usevolt/keypad/sw/doc/l_keypad.jpg

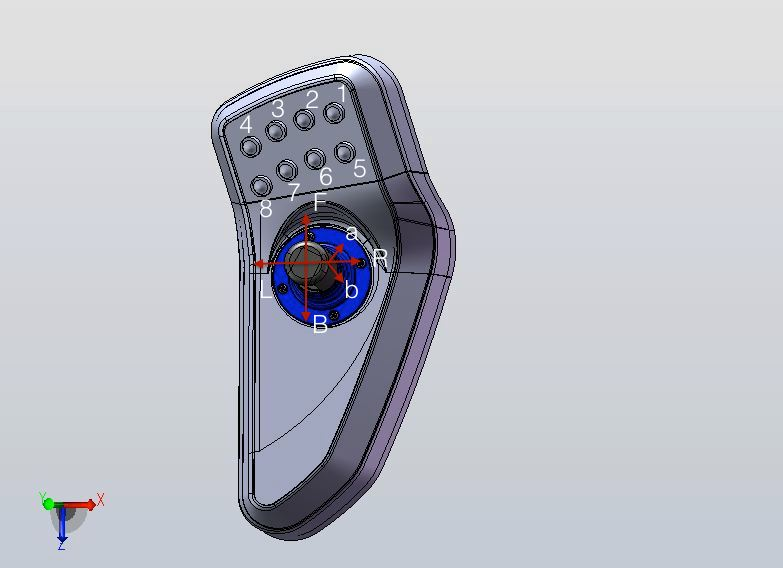
sw/doc/l_keypad.jpg
