usevolt/keypad/sw/doc/r_keypad.jpg

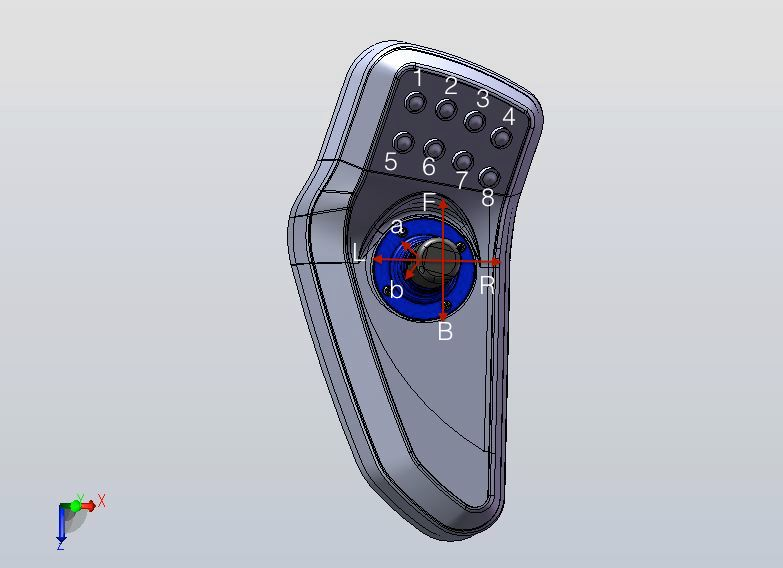
sw/doc/r_keypad.jpg
