usevolt/keypad/hw/angle2.png

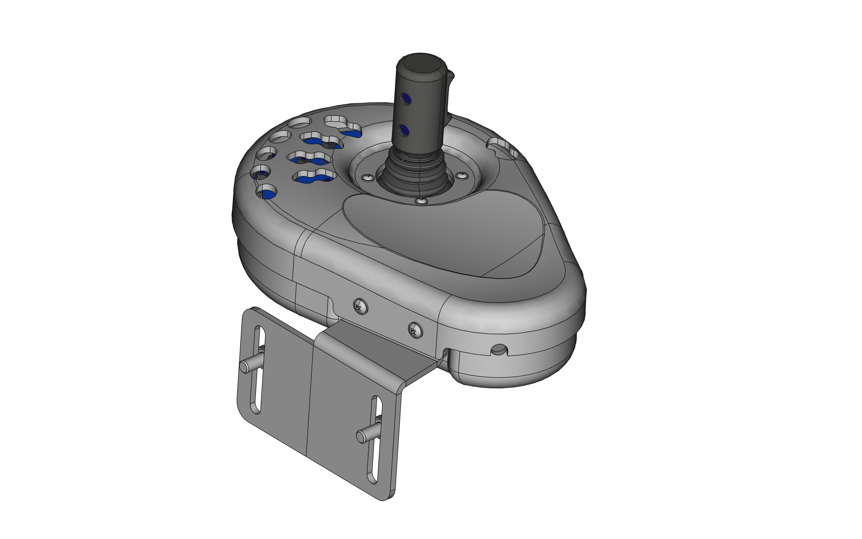
hw/angle2.png
