usevolt/keypad/hw/angle.png

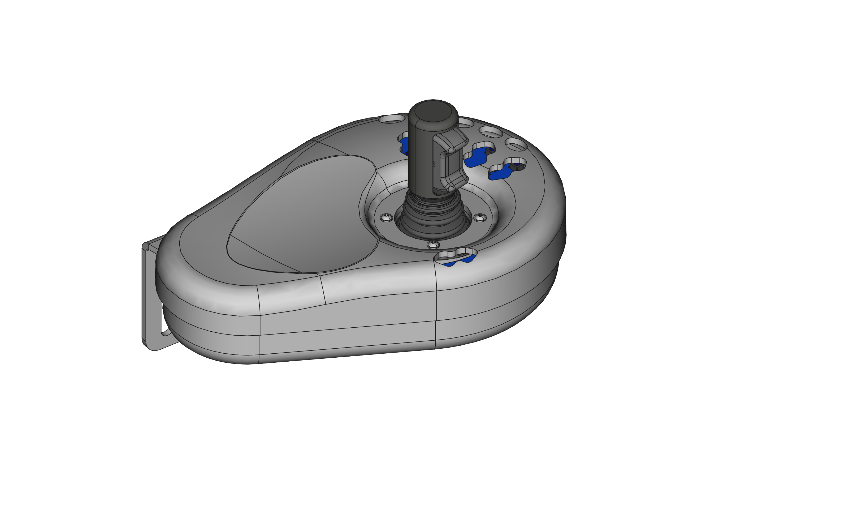
hw/angle.png
