usevolt/keypad/hw/front.png

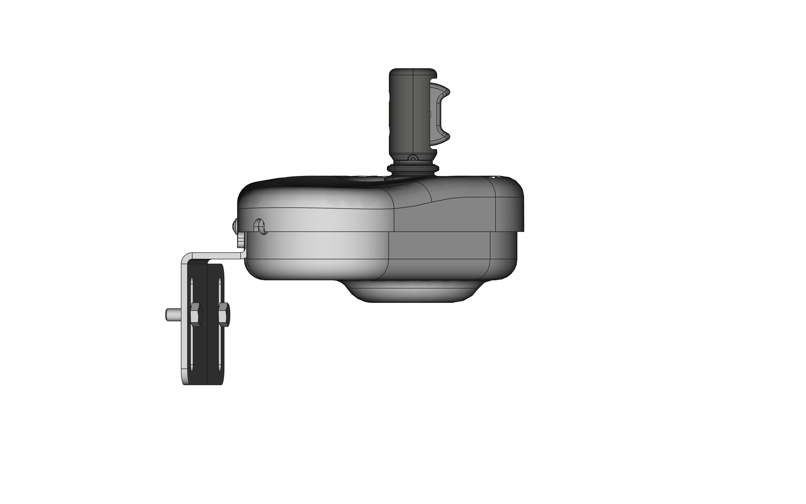
hw/front.png
