usevolt/keypad/hw/right_cover_without_buttons.step

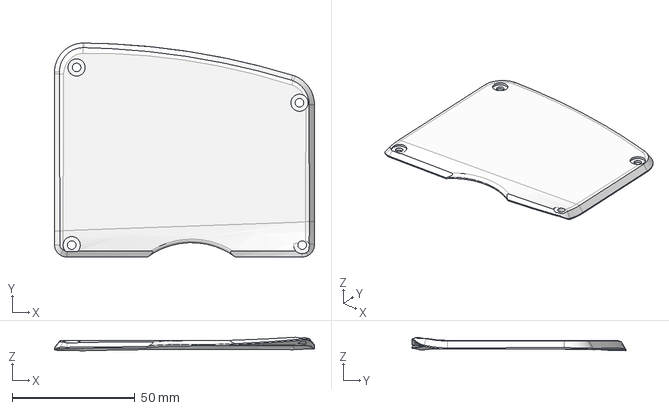
[picture p6: CAD file, 2021-10-26]
hw/right_cover_without_buttons.step
106.0 x 87.2 x 5.54 mm
