usevolt/keypad/hw/right_buttons.stl

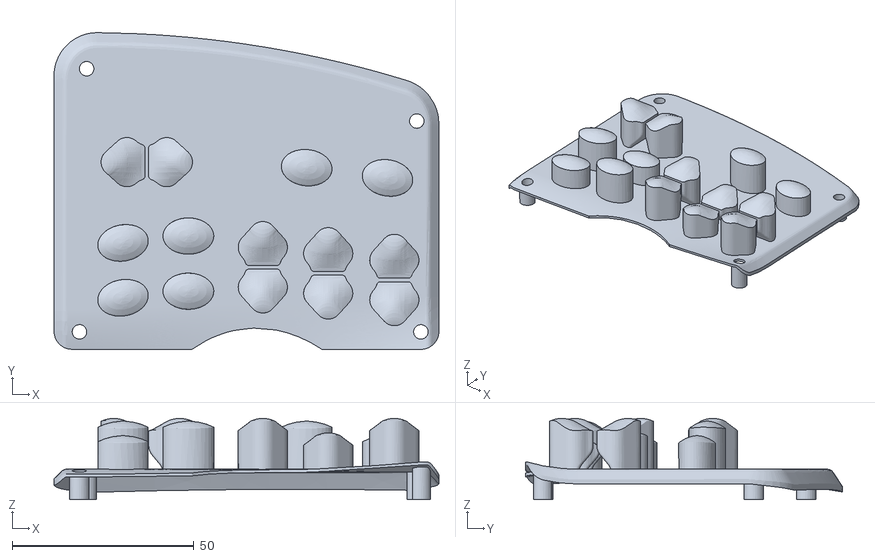
[picture p7: CAD file, 2019-06-02]
hw/right_buttons.stl
106.0 x 87.2 x 22.4
