usevolt/keypad/hw/collar_bottom.iges

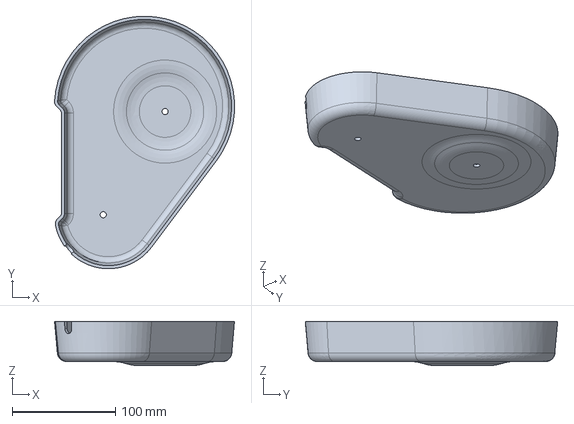
[picture p8: CAD file, 2018-08-27]
hw/collar_bottom.iges
174.5 x 244.8 x 43.0 mm
