usevolt/keypad/hw/collar_top.iges

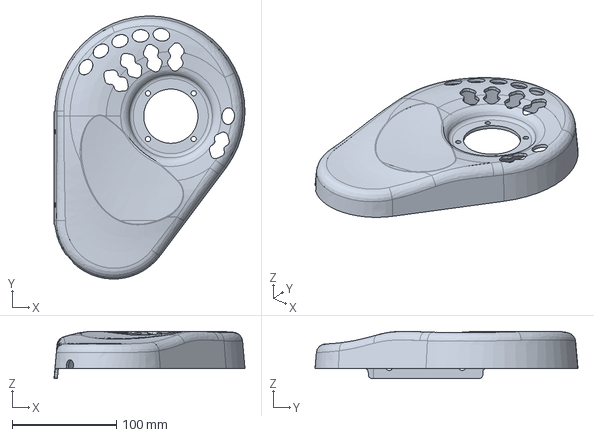
[picture p9: CAD file, 2018-08-27]
hw/collar_top.iges
183.0 x 252.1 x 45.5 mm
