usevolt/keypad/hw/pcb_edges_right.dxf

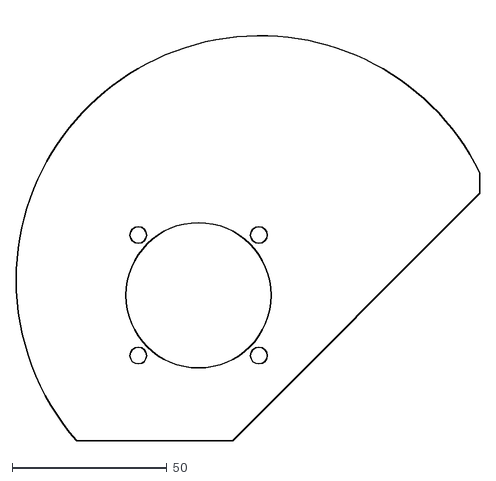
[picture p10: CAD file, 2017-12-17]
hw/pcb_edges_right.dxf
150.0 x 137.3
