usevolt/keypad/hw/joystick_edges_right.dxf

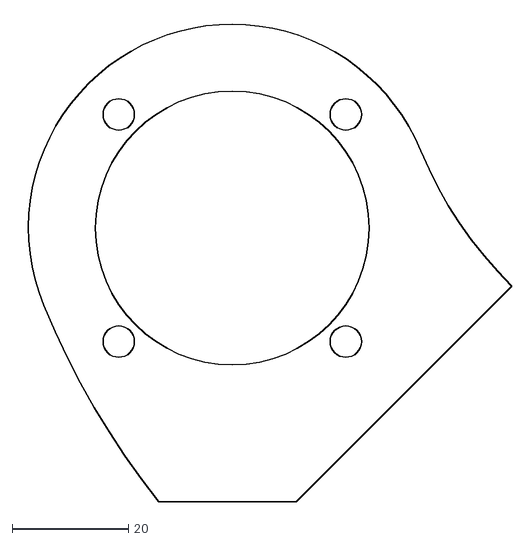
[picture p11: CAD file, 2017-12-17]
hw/joystick_edges_right.dxf
85.2 x 83.4
