usevolt/keypad/hw/left2.FCStd

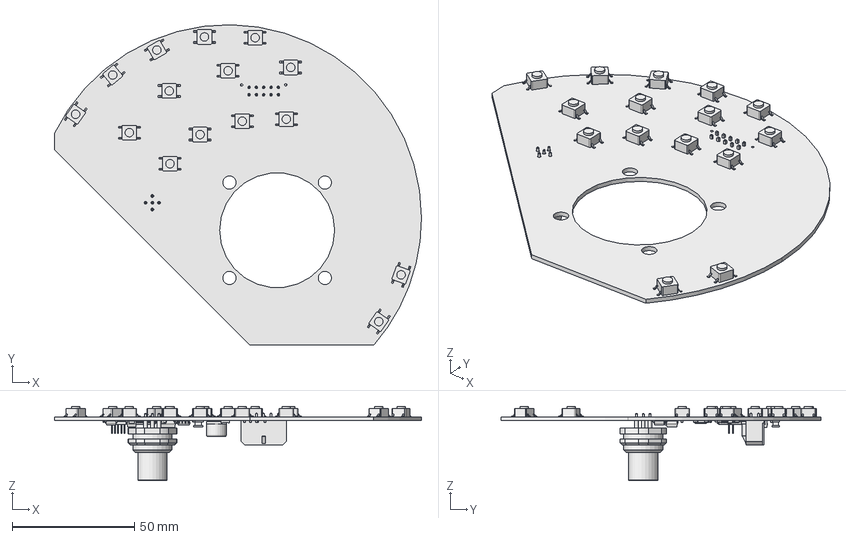
[picture p12: CAD file, 2017-12-17]
hw/left2.FCStd
150.0 x 131.0 x 30.4 mm
