usevolt/keypad/hw/joystick_edges.dxf

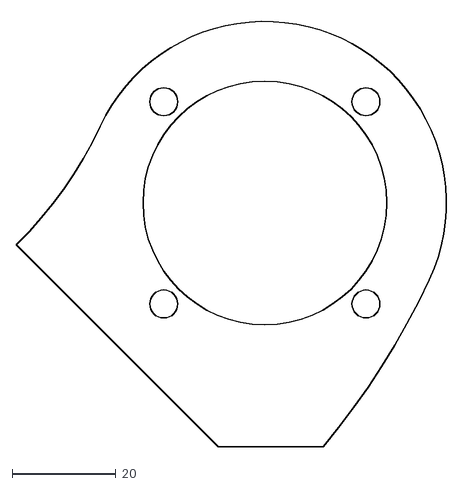
[picture p13: CAD file, 2017-12-17]
hw/joystick_edges.dxf
85.0 x 83.0
