usevolt/keypad/hw/button_edges_right.dxf

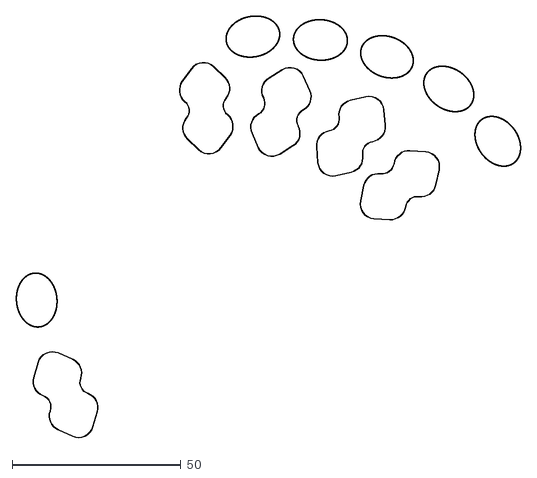
[picture p14: CAD file, 2017-12-17]
hw/button_edges_right.dxf
149.3 x 124.9
