usevolt/keypad/hw/pcb_edges.dxf

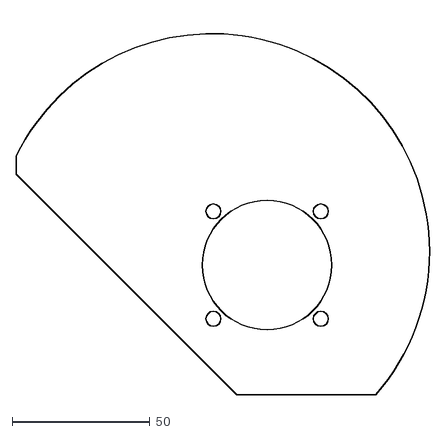
[picture p15: CAD file, 2017-12-17]
hw/pcb_edges.dxf
150.0 x 137.3
