usevolt/keypad/hw/mounting_metal_unfold.dxf

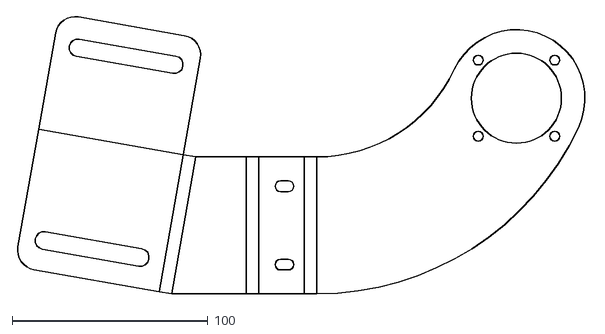
[picture p16: CAD file, 2017-12-17]
hw/mounting_metal_unfold.dxf
292.7 x 142.0
