usevolt/keypad/hw/button_edges.dxf

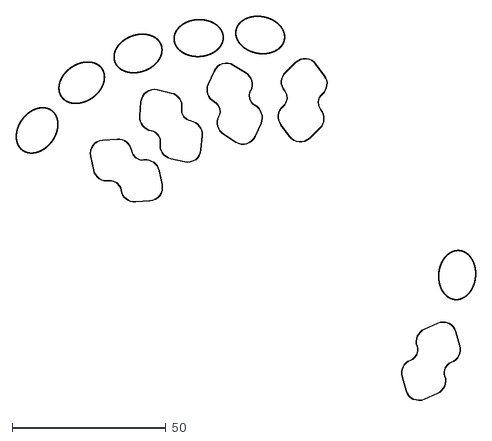
[picture p17: CAD file, 2017-12-17]
hw/button_edges.dxf
149.3 x 124.9
