usevolt/keypad/hw/button_base.step

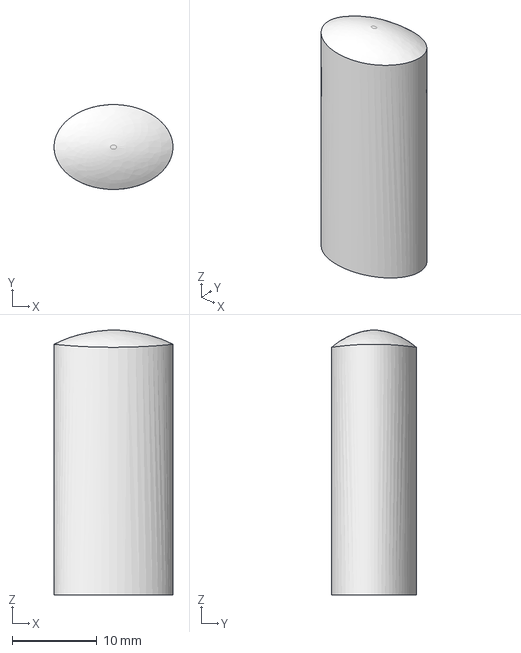
[picture p18: CAD file, 2017-07-12]
hw/button_base.step
14.0 x 9.99 x 31.2 mm
