usevolt/keypad/hw/button_hole_base.step

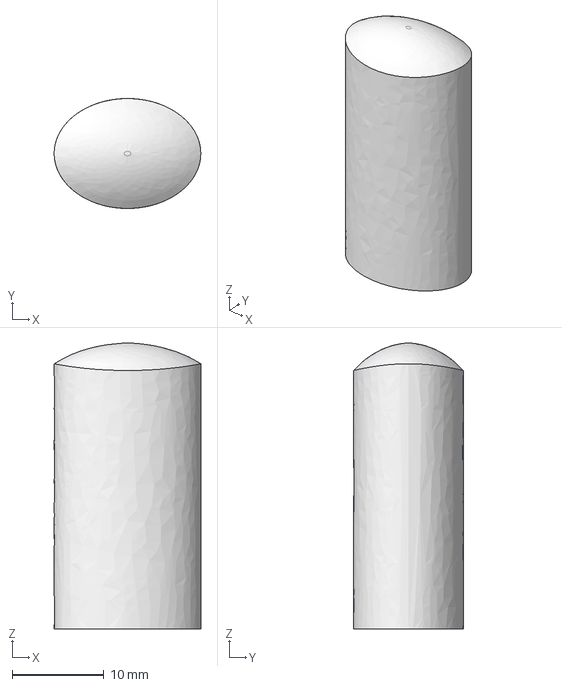
[picture p19: CAD file, 2017-07-12]
hw/button_hole_base.step
16.0 x 12.0 x 31.2 mm
