usevolt/keypad/hw/sw_base.step

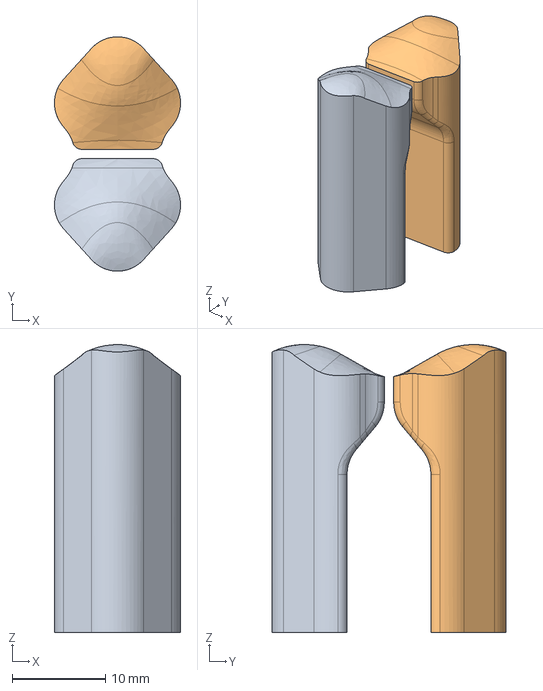
[picture p20: CAD file, 2017-07-12]
hw/sw_base.step
13.6 x 25.2 x 30.9 mm
