usevolt/keypad/hw/sw_hole_base.step

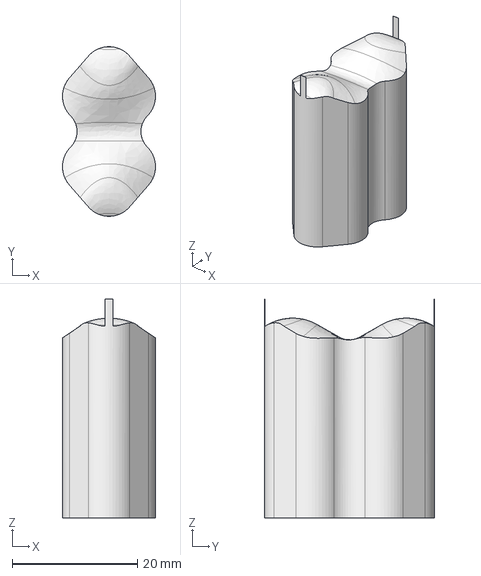
[picture p21: CAD file, 2017-07-12]
hw/sw_hole_base.step
14.9 x 27.1 x 35.0 mm
