usevolt/keypad/hw/right_cover.stl

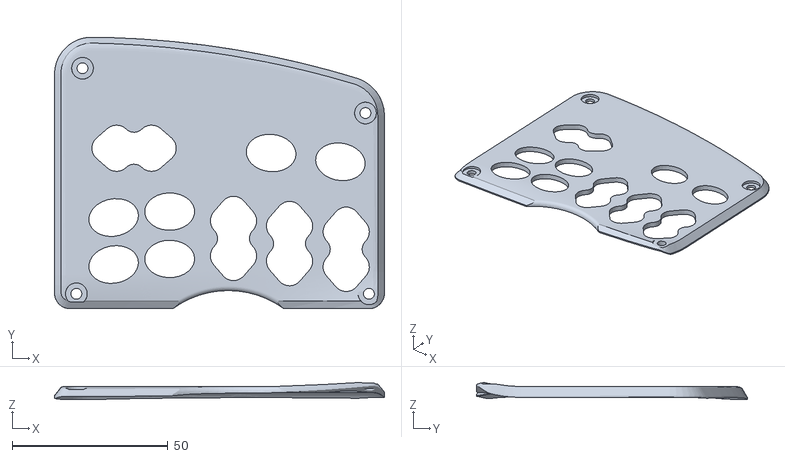
[picture p22: CAD file, 2017-05-18]
hw/right_cover.stl
106.0 x 87.2 x 5.54
