usevolt/keypad/hw/UWP-01004.step

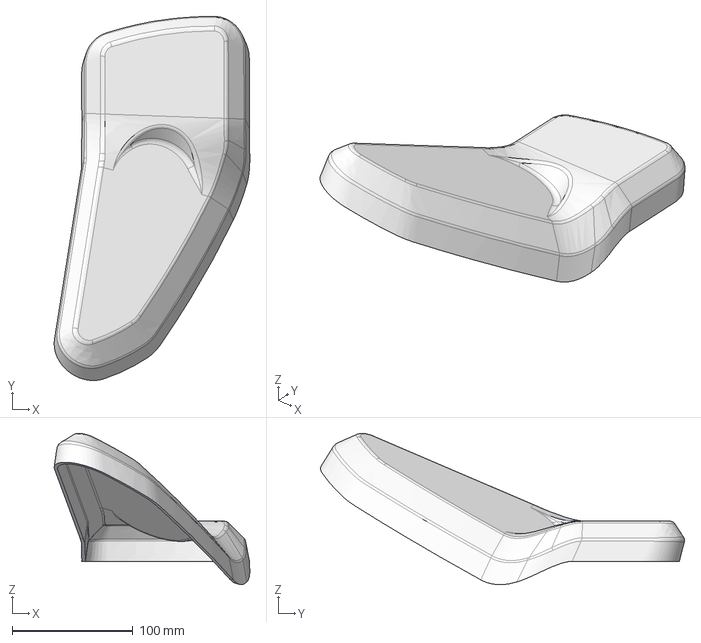
[picture p23: CAD file, 2017-03-28]
hw/UWP-01004.step
162.2 x 301.7 x 125.4 mm
