usevolt/keypad/hw/sw_short_base.step

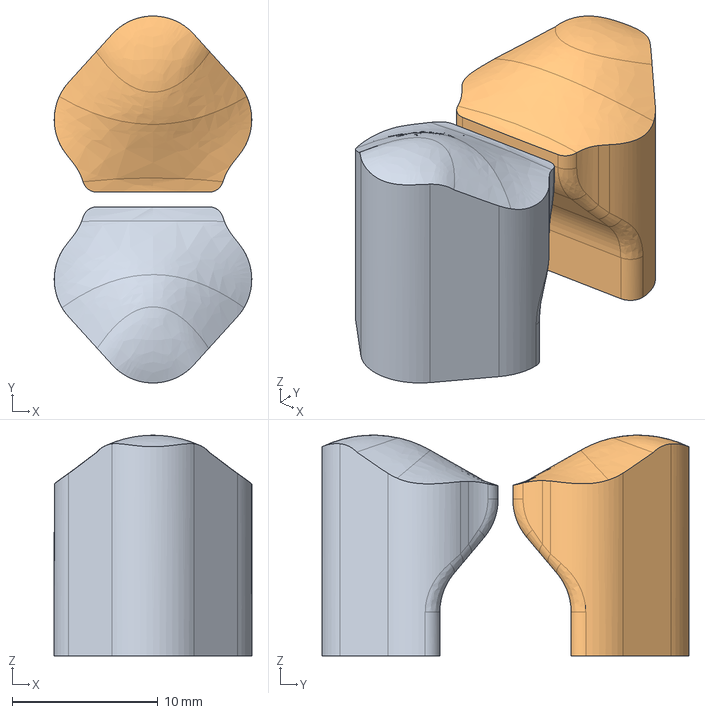
[picture p24: CAD file, 2017-03-28]
hw/sw_short_base.step
13.6 x 25.2 x 15.1 mm
