usevolt/keypad/(list of files, cad)

Other CAD files:
hw/left_cover_without_buttons.step
hw/left_buttons.stl
hw/button_bases.fcstd
hw/left_cover.stl
hw/collar_top.stl
hw/left_cover_without_buttons.stl
hw/right_cover_without_buttons.stl
