usevolt/keypad/docs/left_assembly.png

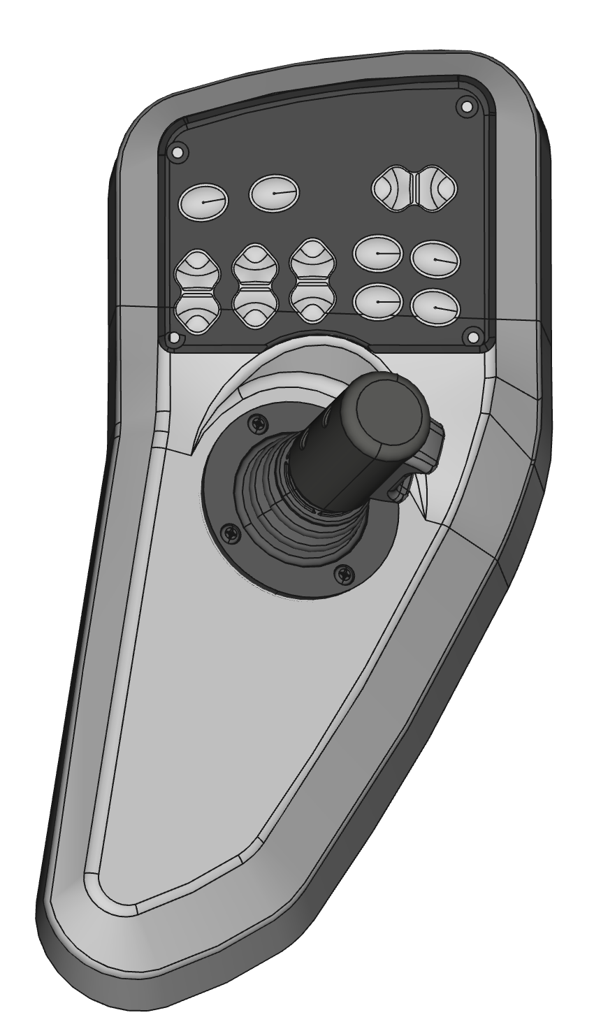
docs/left_assembly.png
