usevolt/keypad/hw/left2.kicad_pcb

## KiCad design hw/left2.kicad_pcb (2017-12-17)

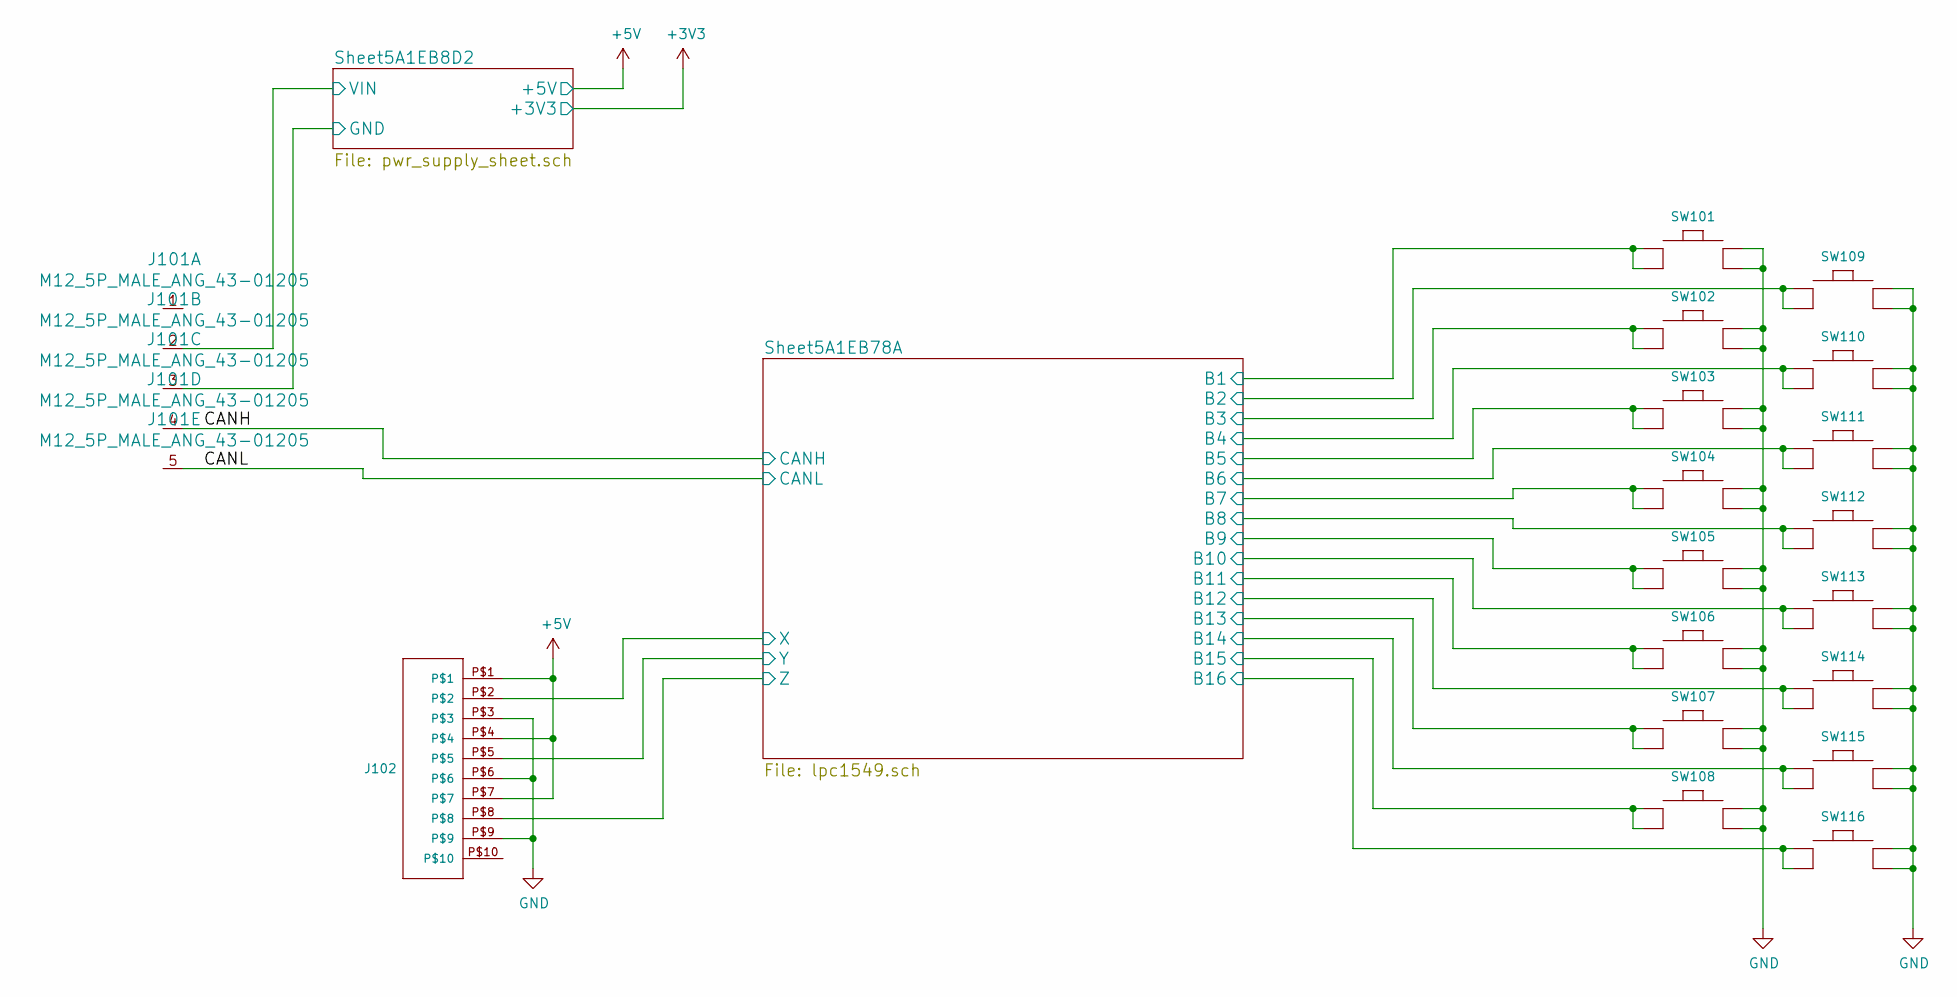
[picture p26: schematic left2.sch]

Parts:
J101: M12_5P_MALE_ANG_43-01205; Manufacturer Part Number 43-01205
J102: MOLEX_MICRO-FIT_10WAY_V; Manufacturer Part Number 43045-1027
SW101, SW102, SW103, SW104, SW105, SW106, SW107, SW108, SW109, SW110, SW111, SW112, SW113, SW114, SW115, SW116: SWITCH_PTS645SM43SMTR92; Manufacturer Part Number PTS645SM43SMTR92 LFS

Connections:
+5V: J102.P$1, J102.P$4, J102.P$7; also elsewhere on the board
/CANH: J101.4; also elsewhere on the board
/CANL: J101.5; also elsewhere on the board
/Sheet5A1EB8D2/VIN: J101.2; also elsewhere on the board
/Sheet5A1EB78A/B1: SW101.1, SW101.2; also elsewhere on the board
/Sheet5A1EB78A/B2: SW109.1, SW109.2; also elsewhere on the board
/Sheet5A1EB78A/B3: SW102.1, SW102.2; also elsewhere on the board
/Sheet5A1EB78A/B4: SW110.1, SW110.2; also elsewhere on the board
/Sheet5A1EB78A/B5: SW103.1, SW103.2; also elsewhere on the board
/Sheet5A1EB78A/B6: SW111.1, SW111.2; also elsewhere on the board
/Sheet5A1EB78A/B7: SW104.1, SW104.2; also elsewhere on the board
/Sheet5A1EB78A/B8: SW112.1, SW112.2; also elsewhere on the board
/Sheet5A1EB78A/B9: SW105.1, SW105.2; also elsewhere on the board
/Sheet5A1EB78A/B10: SW113.1, SW113.2; also elsewhere on the board
/Sheet5A1EB78A/B11: SW106.1, SW106.2; also elsewhere on the board
/Sheet5A1EB78A/B12: SW114.1, SW114.2; also elsewhere on the board
/Sheet5A1EB78A/B13: SW107.1, SW107.2; also elsewhere on the board
/Sheet5A1EB78A/B14: SW115.1, SW115.2; also elsewhere on the board
/Sheet5A1EB78A/B15: SW108.1, SW108.2; also elsewhere on the board
/Sheet5A1EB78A/B16: SW116.1, SW116.2; also elsewhere on the board
/Sheet5A1EB78A/X: J102.P$2; also elsewhere on the board
/Sheet5A1EB78A/Y: J102.P$5; also elsewhere on the board
/Sheet5A1EB78A/Z: J102.P$8; also elsewhere on the board
GND: J101.3, J102.P$3, J102.P$6, J102.P$9, SW101.3, SW101.4, SW102.3, SW102.4, SW103.3, SW103.4, SW104.3, SW104.4, SW105.3, SW105.4, SW106.3, SW106.4, SW107.3, SW107.4, SW108.3, SW108.4, SW109.3, SW109.4, SW110.3, SW110.4, SW111.3, SW111.4, SW112.3, SW112.4, SW113.3, SW113.4, SW114.3, SW114.4, SW115.3, SW115.4, SW116.3, SW116.4; also elsewhere on the board

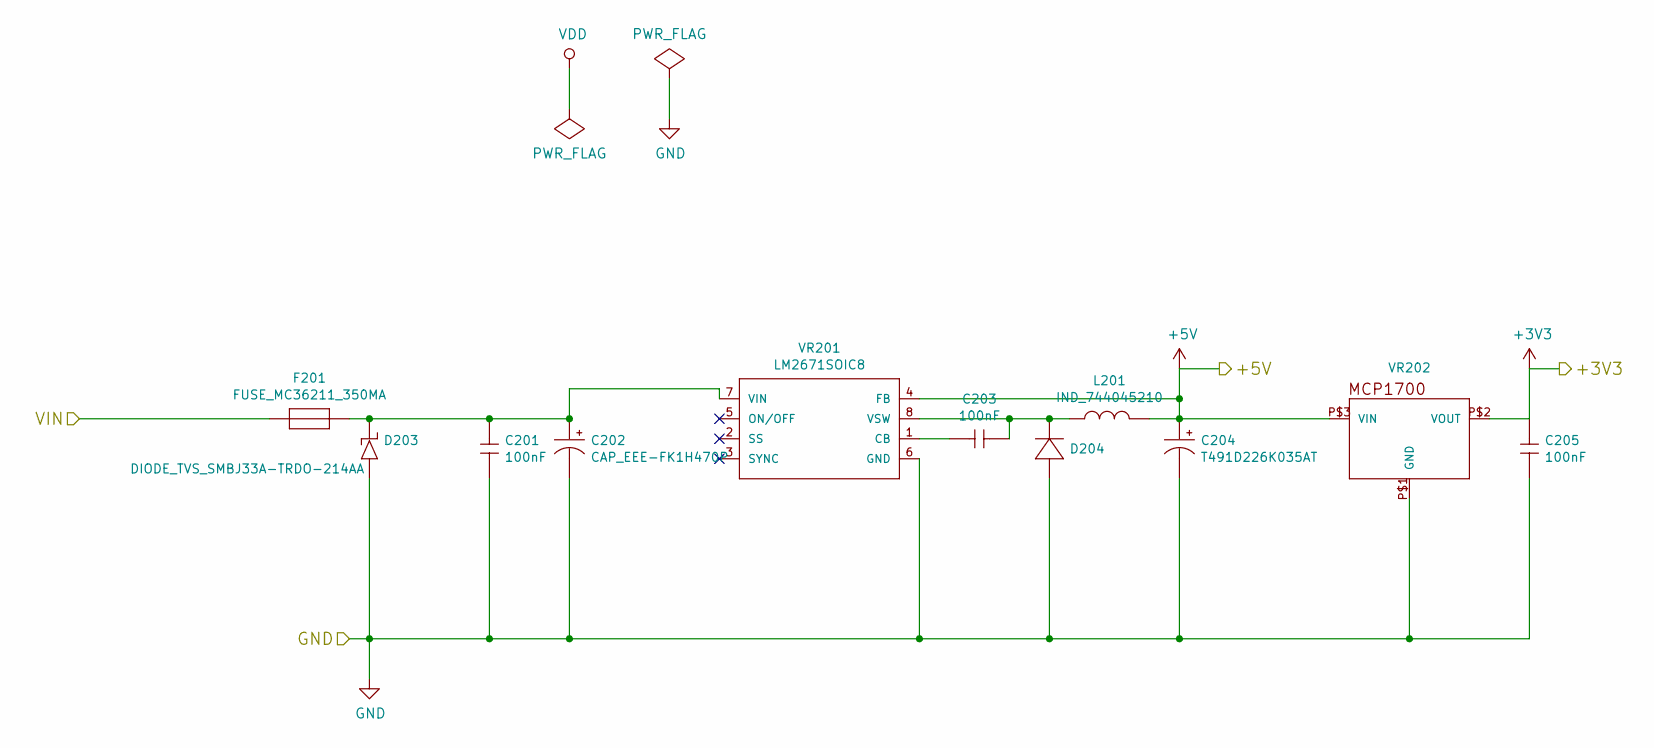
[picture p27: schematic pwr_supply_sheet.sch, Power supply]

Parts:
C201, C203, C205: 100nF; 0603; Manufacturer Part Number C0603C104K5RACTU
C202: CAP_EEE-FK1H470P; Manufacturer Part Number EEE-FK1H470P
C204: T491D226K035AT; 7343; Manufacturer Part Number T491D226K035AT
D203: DIODE_TVS_SMBJ33A-TRDO-214AA; DO-214AA; Manufacturer Part Number SMBJ33A
D204: DIODE_RS07J-GS18; DO219AB; Manufacturer Part Number RS07J-GS18
F201: FUSE_MC36211_350MA; FUSE_MC36211; Manufacturer Part Number MC36211
L201: IND_744045210; Manufacturer Part Number 744045210
VR201: LM2671SOIC8; SOIC8; Manufacturer Part Number LM2671M-5.0/NOPB
VR202: REG_MCP1700; SOT-23_3-PIN; Manufacturer Part Number MCP1700T-3302E/TT

Connections:
+3V3: C205.1 (C1), VR202.P$2 (VOUT); also elsewhere on the board
+5V: C204.+, L201.2, VR201.4 (FB), VR202.P$3 (VIN); also elsewhere on the board
/Sheet5A1EB8D2/VIN: F201.P$1; also elsewhere on the board
GND: C201.2 (C2), C202.-, C204.-, C205.2 (C2), D203.P$1, D204.P$1, VR201.6 (GND), VR202.P$1 (GND); also elsewhere on the board
unnamed: C201.1 (C1), C202.+, D203.P$2 (N), F201.P$2, VR201.7 (VIN)
unnamed: C203.1 (C1), VR201.1 (CB)
unnamed: C203.2 (C2), D204.P$2 (N), L201.1, VR201.8 (VSW)

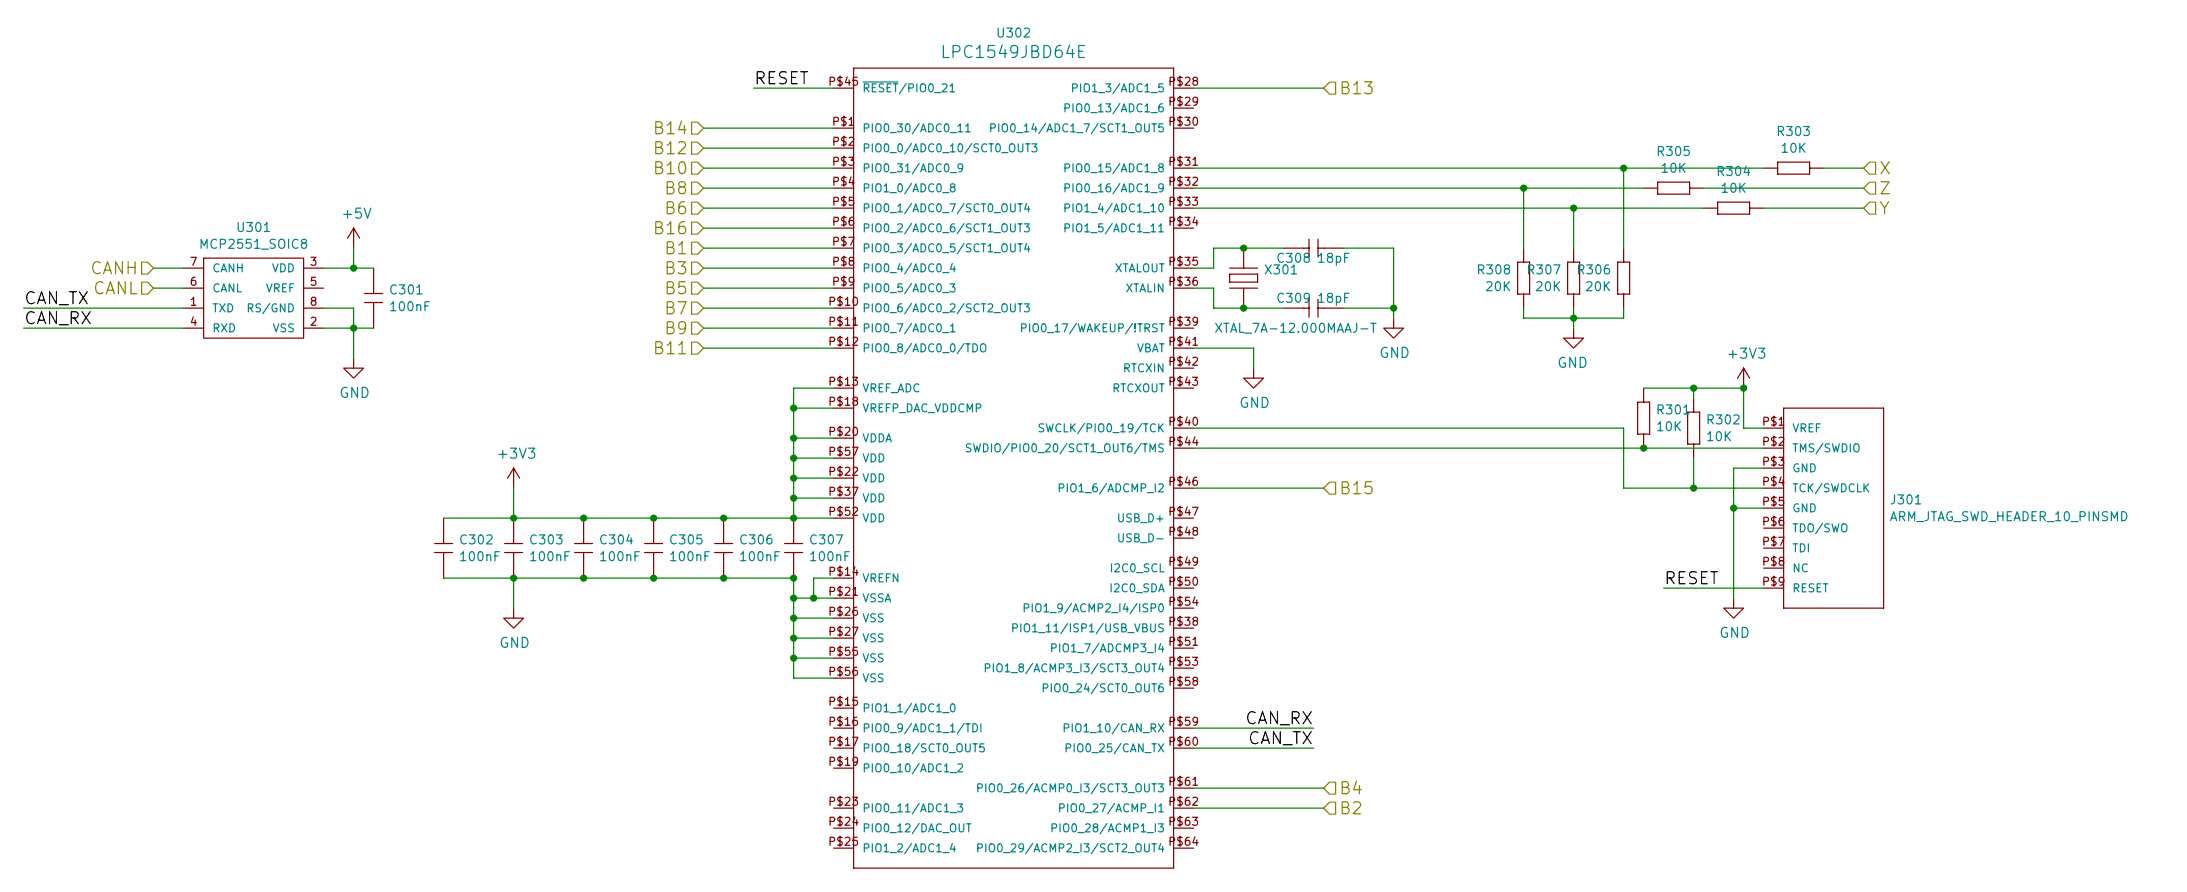
[picture p28: schematic lpc1549.sch]

Parts:
C301, C302, C303, C304, C305, C306, C307: 100nF; 0603; Manufacturer Part Number C0603C104K5RACTU
C308, C309: 18pF; 0603; Manufacturer Part Number C0603C180J2GACTU
J301: ARM_JTAG_SWD_HEADER_10_PINSMD; ARM_10_PIN_JTAG_SWD_CONNECTOR; Manufacturer Part Number 20021121-00010C4LF
R301, R302: 10K; 0603; Manufacturer Part Number MC0063W0603110K
R303, R304, R305: 10K; 0603; Manufacturer Part Number RC0603FR-0710KL
R306, R307, R308: 20K; 0603; Manufacturer Part Number RC0603FR-0720KL
U301: MCP2551_SOIC8; SOIC8; Manufacturer Part Number MCP2551-I/SN
U302: LPC1549JBD64; QFP64; Manufacturer Part Number LPC1549JBD64E
X301: XTAL_7A-12.000MAAJ-T; XTAL_7A-20.000MAJ; Manufacturer Part Number 7A-12.000MAAJ-T

Connections:
+3V3: C302.1 (C1), C303.1 (C1), C304.1 (C1), C305.1 (C1), C306.1 (C1), C307.1 (C1), J301.P$1 (VREF), R301.2 (R2), R302.2 (R2), U302.P$13 (VREF_ADC), U302.P$18 (VREFP_DAC_VDDCMP), U302.P$20 (VDDA), U302.P$22 (VDD), U302.P$37 (VDD), U302.P$52 (VDD), U302.P$57 (VDD); also elsewhere on the board
+5V: C301.1 (C1), U301.3 (VDD); also elsewhere on the board
/CANH: U301.7 (CANH); also elsewhere on the board
/CANL: U301.6 (CANL); also elsewhere on the board
/Sheet5A1EB78A/B1: U302.P$7 (PIO0_3/ADC0_5/SCT1_OUT4); also elsewhere on the board
/Sheet5A1EB78A/B2: U302.P$62 (PIO0_27/ACMP_I1); also elsewhere on the board
/Sheet5A1EB78A/B3: U302.P$8 (PIO0_4/ADC0_4); also elsewhere on the board
/Sheet5A1EB78A/B4: U302.P$61 (PIO0_26/ACMP0_I3/SCT3_OUT3); also elsewhere on the board
/Sheet5A1EB78A/B5: U302.P$9 (PIO0_5/ADC0_3); also elsewhere on the board
/Sheet5A1EB78A/B6: U302.P$5 (PIO0_1/ADC0_7/SCT0_OUT4); also elsewhere on the board
/Sheet5A1EB78A/B7: U302.P$10 (PIO0_6/ADC0_2/SCT2_OUT3); also elsewhere on the board
/Sheet5A1EB78A/B8: U302.P$4 (PIO1_0/ADC0_8); also elsewhere on the board
/Sheet5A1EB78A/B9: U302.P$11 (PIO0_7/ADC0_1); also elsewhere on the board
/Sheet5A1EB78A/B10: U302.P$3 (PIO0_31/ADC0_9); also elsewhere on the board
/Sheet5A1EB78A/B11: U302.P$12 (PIO0_8/ADC0_0/TDO); also elsewhere on the board
/Sheet5A1EB78A/B12: U302.P$2 (PIO0_0/ADC0_10/SCT0_OUT3); also elsewhere on the board
/Sheet5A1EB78A/B13: U302.P$28 (PIO1_3/ADC1_5); also elsewhere on the board
/Sheet5A1EB78A/B14: U302.P$1 (PIO0_30/ADC0_11); also elsewhere on the board
/Sheet5A1EB78A/B15: U302.P$46 (PIO1_6/ADCMP_I2); also elsewhere on the board
/Sheet5A1EB78A/B16: U302.P$6 (PIO0_2/ADC0_6/SCT1_OUT3); also elsewhere on the board
/Sheet5A1EB78A/CAN_RX: U301.4 (RXD), U302.P$59 (PIO1_10/CAN_RX)
/Sheet5A1EB78A/CAN_TX: U301.1 (TXD), U302.P$60 (PIO0_25/CAN_TX)
/Sheet5A1EB78A/RESET: J301.P$9 (RESET), U302.P$45 (~RESET~/PIO0_21)
/Sheet5A1EB78A/X: R303.1 (R1); also elsewhere on the board
/Sheet5A1EB78A/Y: R304.1 (R1); also elsewhere on the board
/Sheet5A1EB78A/Z: R305.1 (R1); also elsewhere on the board
GND: C301.2 (C2), C302.2 (C2), C303.2 (C2), C304.2 (C2), C305.2 (C2), C306.2 (C2), C307.2 (C2), C308.2 (C2), C309.2 (C2), J301.P$3 (GND), J301.P$5 (GND), R306.1 (R1), R307.1 (R1), R308.1 (R1), U301.2 (VSS), U301.8 (RS/GND), U302.P$14 (VREFN), U302.P$21 (VSSA), U302.P$26 (VSS), U302.P$27 (VSS), U302.P$41 (VBAT), U302.P$55 (VSS), U302.P$56 (VSS); also elsewhere on the board
unnamed: C308.1 (C1), U302.P$35 (XTALOUT), X301.P$1
unnamed: C309.1 (C1), U302.P$36 (XTALIN), X301.P$2
unnamed: J301.P$2 (TMS/SWDIO), R301.1 (R1), U302.P$44 (SWDIO/PIO0_20/SCT1_OUT6/TMS)
unnamed: J301.P$4 (TCK/SWDCLK), R302.1 (R1), U302.P$40 (SWCLK/PIO0_19/TCK)
unnamed: R303.2 (R2), R306.2 (R2), U302.P$31 (PIO0_15/ADC1_8)
unnamed: R304.2 (R2), R307.2 (R2), U302.P$33 (PIO1_4/ADC1_10)
unnamed: R305.2 (R2), R308.2 (R2), U302.P$32 (PIO0_16/ADC1_9)

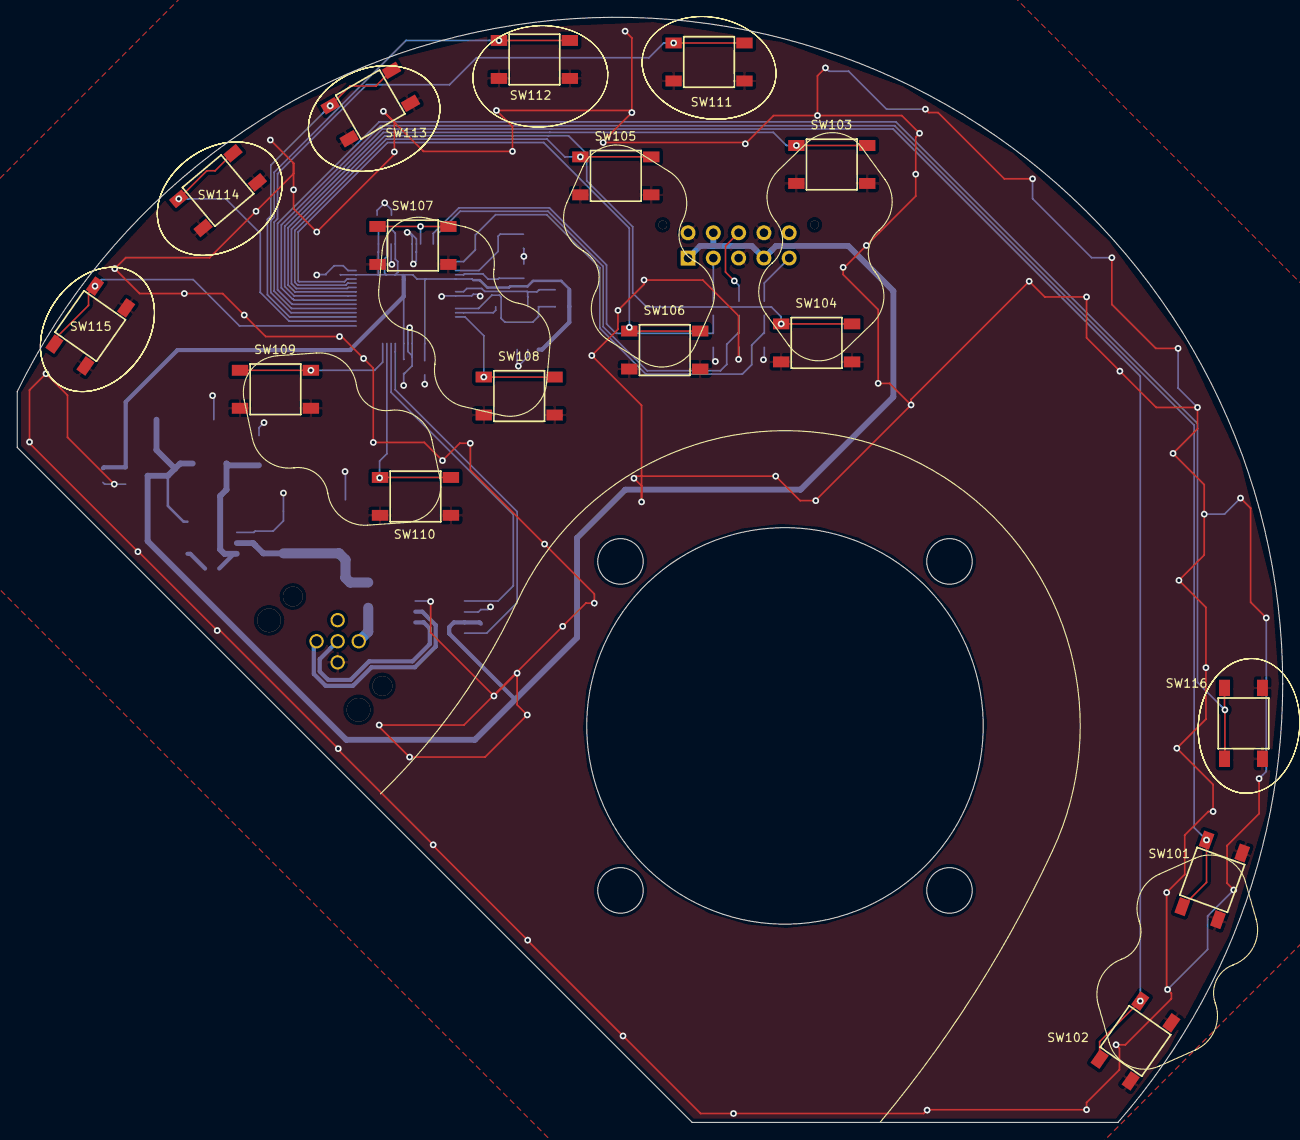
[picture p29: board left2.kicad_pcb from above]

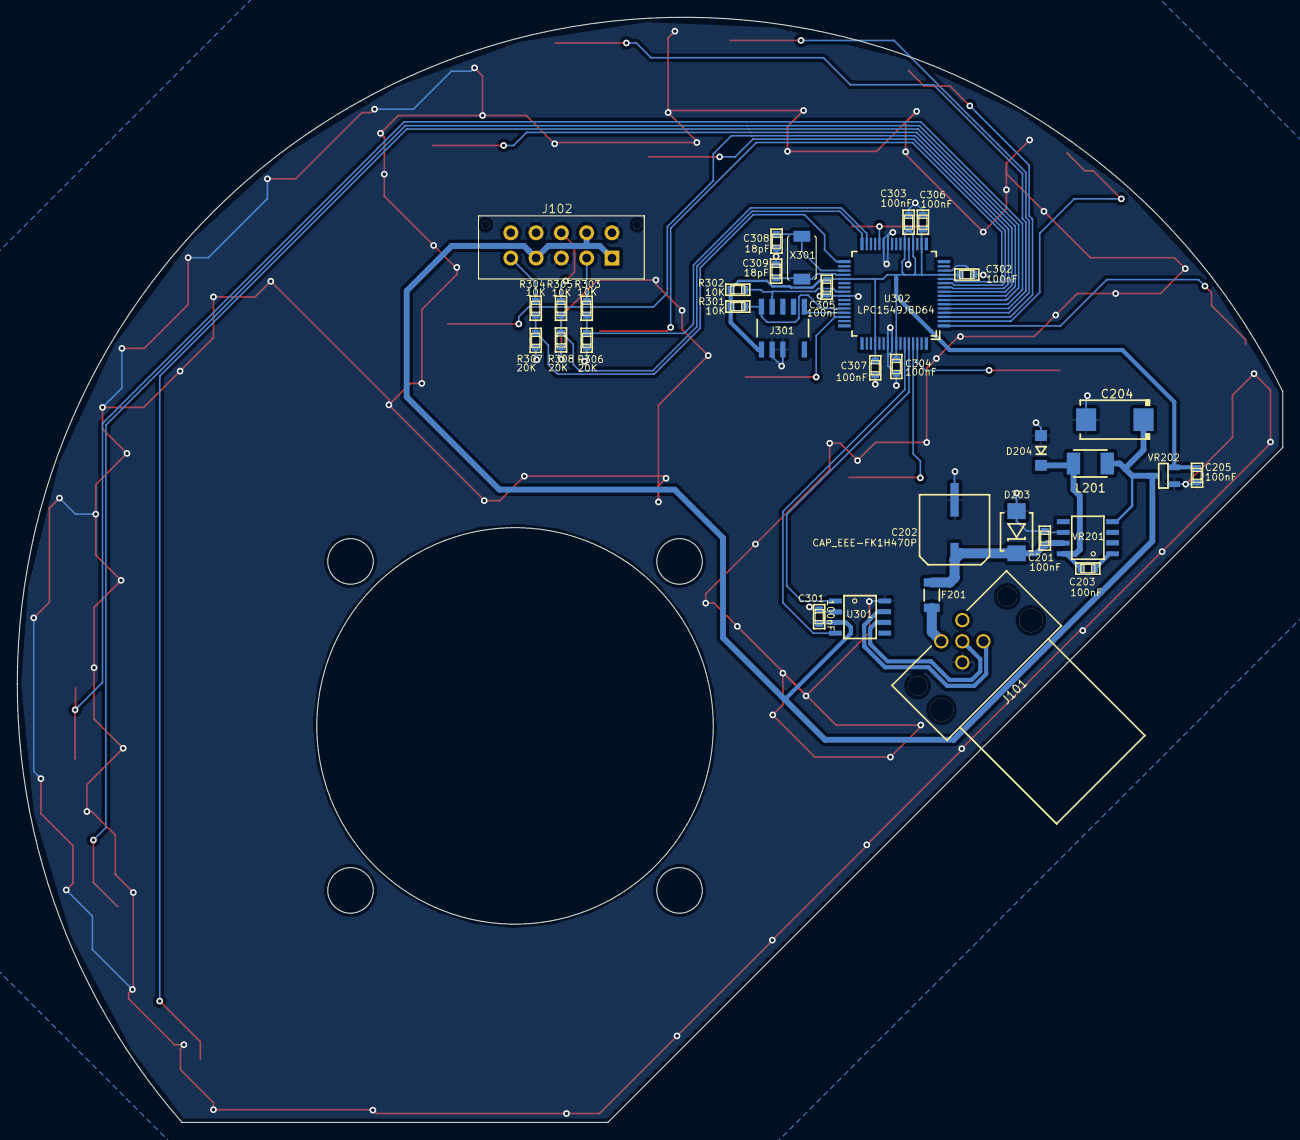
[picture p30: board left2.kicad_pcb from below]

Board: 2 copper layers, 150.0 x 131.0 mm, 50 parts (34 on the bottom side), 38 nets.
