usevolt/keypad/hw/right_keypad.kicad_pcb

## KiCad design hw/right_keypad.kicad_pcb (2017-12-17)

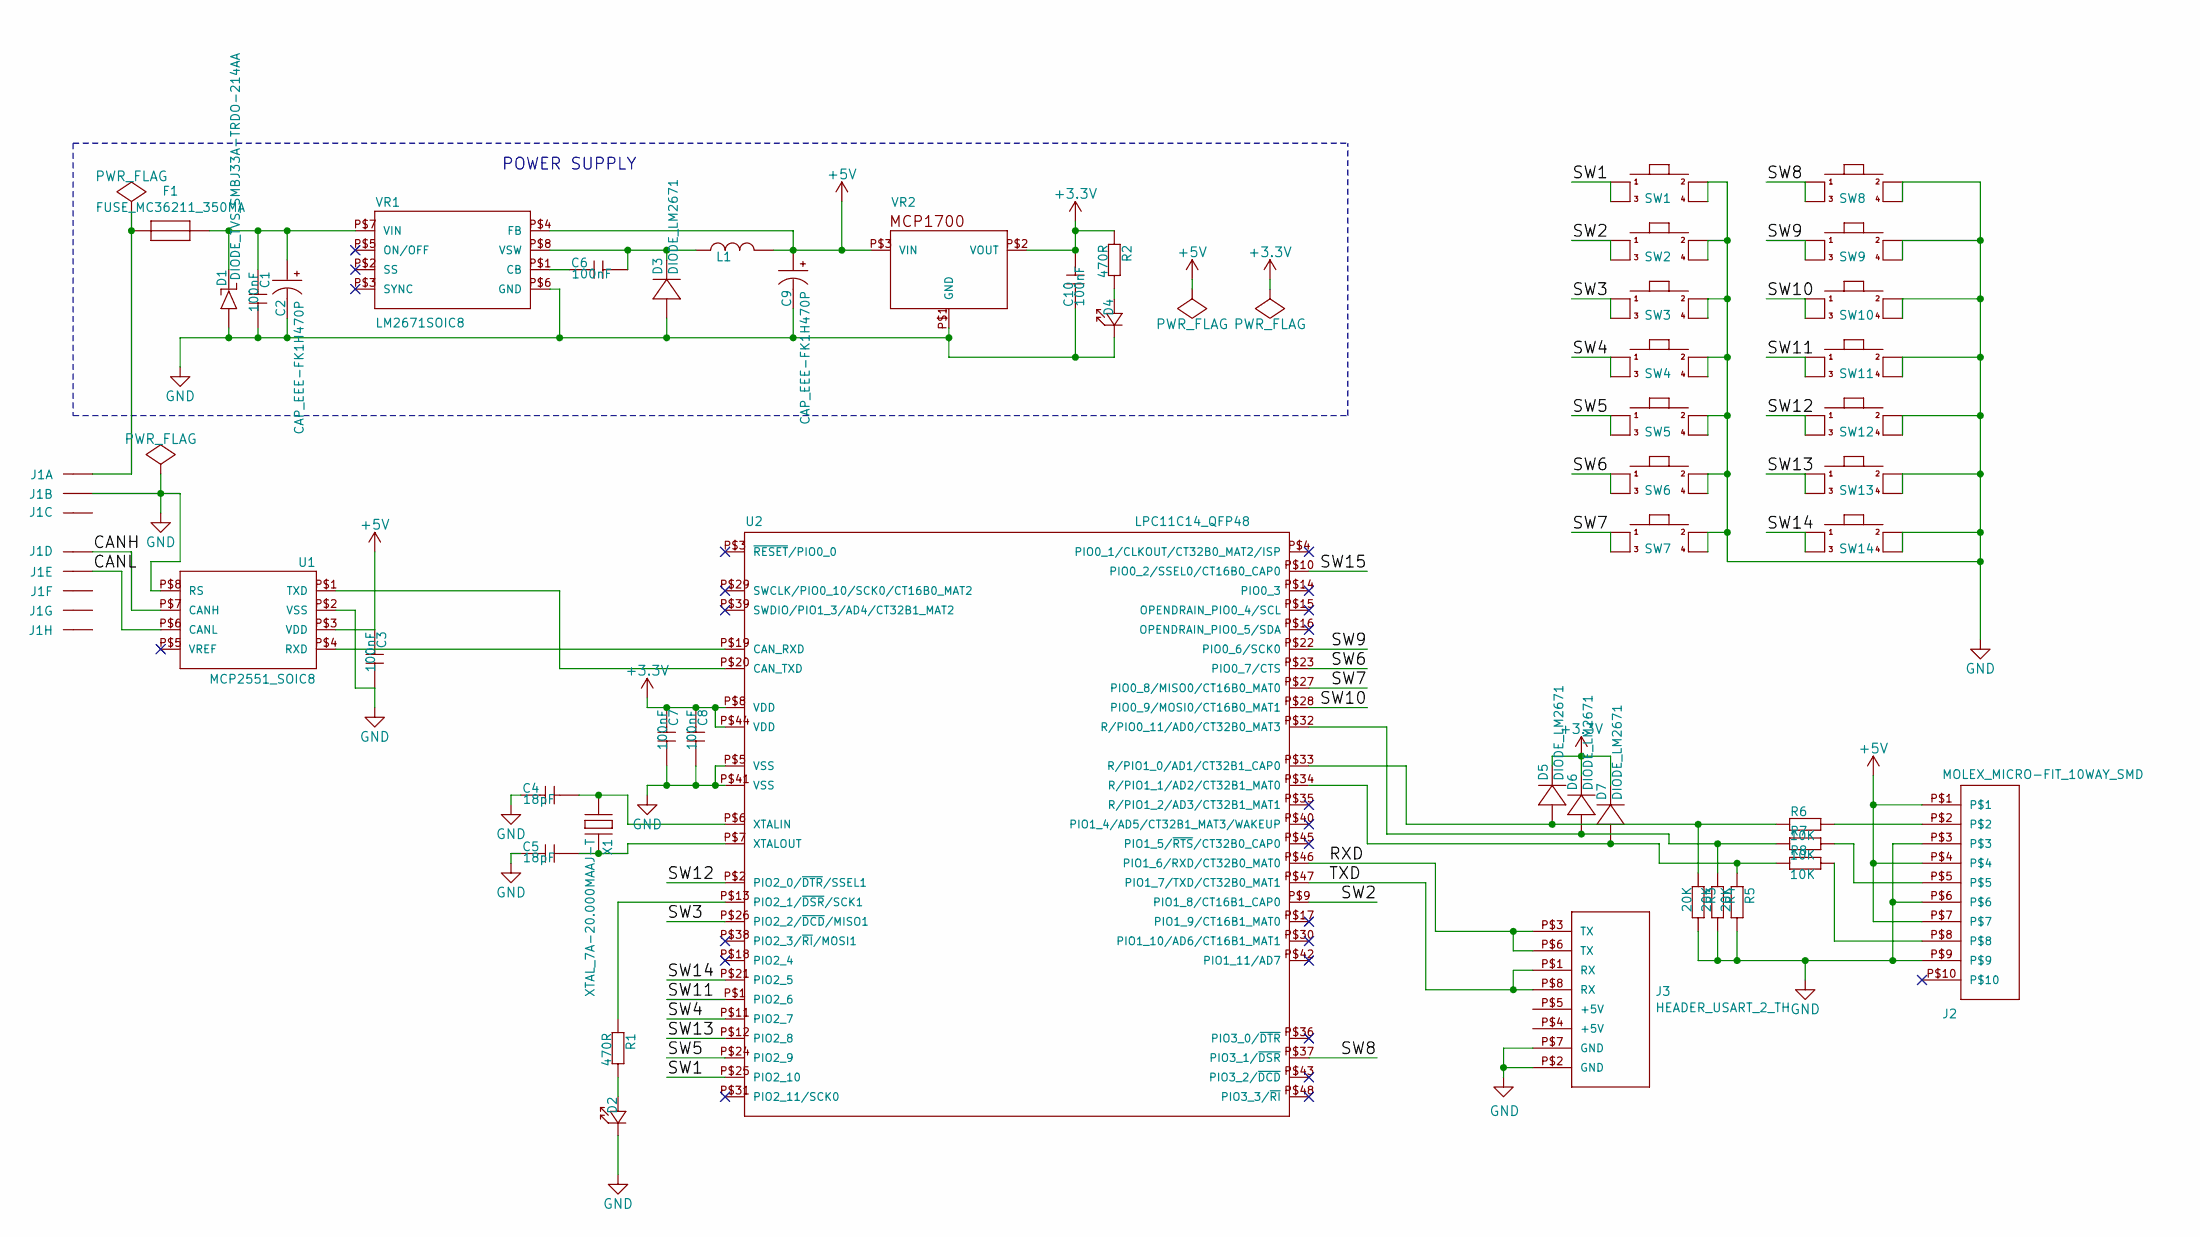
[picture p31: schematic right_keypad.sch, UW Left Keypad]

Parts:
C1, C3, C6, C7, C8, C10: 100nF; 0603; Manufacturer Part Number C0603C104K5RACTU
C2, C9: CAP_EEE-FK1H470P; Manufacturer Part Number EEE-FK1H470P
C4, C5: 18pF; 0603; Manufacturer Part Number C0603C180J2GACTU
D1: DIODE_TVS_SMBJ33A-TRDO-214AA; DO-214AA; Manufacturer Part Number SMBJ33A
D2, D4: WL-SMCW-150060BS75000-B; 0603; Manufacturer Part Number 150060BS75000
D3, D5, D6, D7: DIODE_LM2671; DO219AB; Manufacturer Part Number RS07J-GS18
F1: FUSE_MC36211_350MA; FUSE_MC36211; Manufacturer Part Number MC36211
J1: AMPSEAL_8_POS_776275-1; Manufacturer Part Number 776275-1
J2: MOLEX_MICRO-FIT_10WAY_SMD; MOLEX_MICRO-FIT_10WAY_V; Manufacturer Part Number 43045-1027
J3: HEADER_USART_2_TH
L1: INDUCTOR_SDR1005-101KL; INDUCTOR_BOURNS_10X13X5MM; Manufacturer Part Number SDR1005-101KL
R1, R2: 470R; 0603; Manufacturer Part Number MC0063W06031470R
R3, R4, R5: 20K; 0603; Manufacturer Part Number MC0063W0603120K
R6, R7, R8: 10K; 0603; Manufacturer Part Number MC0063W0603110K
SW1, SW2, SW3, SW4, SW5, SW6, SW7, SW8, SW9, SW10, SW11, SW12, SW13, SW14: SWITCH_B3W-4050; Manufacturer Part Number B3W-4050
U1: MCP2551_SOIC8; SOIC8; Manufacturer Part Number MCP2551-I/SN
U2: LPC11C14_QFP48; QFP48; Manufacturer Part Number LPC11C14FBD48/301
VR1: LM2671SOIC8; SOIC8; Manufacturer Part Number LM2671M-5.0/NOPB
VR2: REG_MCP1700; SOT-23_3-PIN; Manufacturer Part Number MCP1700T-3302E/TT
X1: XTAL_7A-20.000MAAJ-T; XTAL_7A-20.000MAJ; Manufacturer Part Number 7A-20.000MAAJ-T

Connections:
+3V3: C7.1 (C1), C8.1 (C1), C10.2 (C2), D5.P$2 (N), D6.P$2 (N), D7.P$2 (N), R2.2 (R2), U2.P$8 (VDD), U2.P$44 (VDD), VR2.P$2 (VOUT)
+5V: C3.1 (C1), C9.+, J2.P$1, J2.P$4, J2.P$7, L1.P$2, U1.P$3 (VDD), VR1.P$4 (FB), VR2.P$3 (VIN)
/CANH: J1.P$4, U1.P$7 (CANH)
/CANL: J1.P$5, U1.P$6 (CANL)
/RXD: J3.P$3 (TX), J3.P$6 (TX), U2.P$46 (PIO1_6/RXD/CT32B0_MAT0)
/SW1: SW1.P$1, SW1.P$2, U2.P$25 (PIO2_10)
/SW2: SW2.P$1, SW2.P$2, U2.P$9 (PIO1_8/CT16B1_CAP0)
/SW3: SW3.P$1, SW3.P$2, U2.P$26 (PIO2_2/~DCD~/MISO1)
/SW4: SW4.P$1, SW4.P$2, U2.P$11 (PIO2_7)
/SW5: SW5.P$1, SW5.P$2, U2.P$24 (PIO2_9)
/SW6: SW6.P$1, SW6.P$2, U2.P$23 (PIO0_7/CTS)
/SW7: SW7.P$1, SW7.P$2, U2.P$27 (PIO0_8/MISO0/CT16B0_MAT0)
/SW8: SW8.P$1, SW8.P$2, U2.P$37 (PIO3_1/~DSR)
/SW9: SW9.P$1, SW9.P$2, U2.P$22 (PIO0_6/SCK0)
/SW10: SW10.P$1, SW10.P$2, U2.P$28 (PIO0_9/MOSI0/CT16B0_MAT1)
/SW11: SW11.P$1, SW11.P$2, U2.P$1 (PIO2_6)
/SW12: SW12.P$1, SW12.P$2, U2.P$2 (PIO2_0/~DTR~/SSEL1)
/SW13: SW13.P$1, SW13.P$2, U2.P$12 (PIO2_8)
/SW14: SW14.P$1, SW14.P$2, U2.P$21 (PIO2_5)
/TXD: J3.P$1 (RX), J3.P$8 (RX), U2.P$47 (PIO1_7/TXD/CT32B0_MAT1)
GND: C1.2 (C2), C2.-, C3.2 (C2), C4.1 (C1), C5.1 (C1), C7.2 (C2), C8.2 (C2), C9.-, C10.1 (C1), D1.P$1, D2.1 (K), D3.P$1, D4.1 (K), J1.P$2, J2.P$3, J2.P$6, J2.P$9, J3.P$2 (GND), J3.P$7 (GND), R3.1 (R1), R4.1 (R1), R5.1 (R1), SW1.P$3, SW1.P$4, SW2.P$3, SW2.P$4, SW3.P$3, SW3.P$4, SW4.P$3, SW4.P$4, SW5.P$3, SW5.P$4, SW6.P$3, SW6.P$4, SW7.P$3, SW7.P$4, SW8.P$3, SW8.P$4, SW9.P$3, SW9.P$4, SW10.P$3, SW10.P$4, SW11.P$3, SW11.P$4, SW12.P$3, SW12.P$4, SW13.P$3, SW13.P$4, SW14.P$3, SW14.P$4, U1.P$2 (VSS), U1.P$8 (RS), U2.P$5 (VSS), U2.P$41 (VSS), VR1.P$6 (GND), VR2.P$1 (GND)
unnamed: C1.1 (C1), C2.+, D1.P$2 (N), F1.P$2, VR1.P$7 (VIN)
unnamed: C4.2 (C2), U2.P$6 (XTALIN), X1.P$1
unnamed: C5.2 (C2), U2.P$7 (XTALOUT), X1.P$2
unnamed: C6.1 (C1), VR1.P$1 (CB)
unnamed: C6.2 (C2), D3.P$2 (N), L1.P$1, VR1.P$8 (VSW)
unnamed: D2.2 (A), R1.1 (R1)
unnamed: D4.2 (A), R2.1 (R1)
unnamed: D5.P$1, R3.2 (R2), R6.2 (R2), U2.P$33 (R/PIO1_0/AD1/CT32B1_CAP0)
unnamed: D6.P$1, R4.2 (R2), R7.2 (R2), U2.P$32 (R/PIO0_11/AD0/CT32B0_MAT3)
unnamed: D7.P$1, R5.2 (R2), R8.2 (R2), U2.P$34 (R/PIO1_1/AD2/CT32B1_MAT0)
unnamed: F1.P$1, J1.P$1
unnamed: J2.P$2, R6.1 (R1)
unnamed: J2.P$5, R7.1 (R1)
unnamed: J2.P$8, R8.1 (R1)
unnamed: R1.2 (R2), U2.P$13 (PIO2_1/~DSR~/SCK1)
unnamed: U1.P$1 (TXD), U2.P$20 (CAN_TXD)
unnamed: U1.P$4 (RXD), U2.P$19 (CAN_RXD)

Notes on the sheet:
POWER SUPPLY

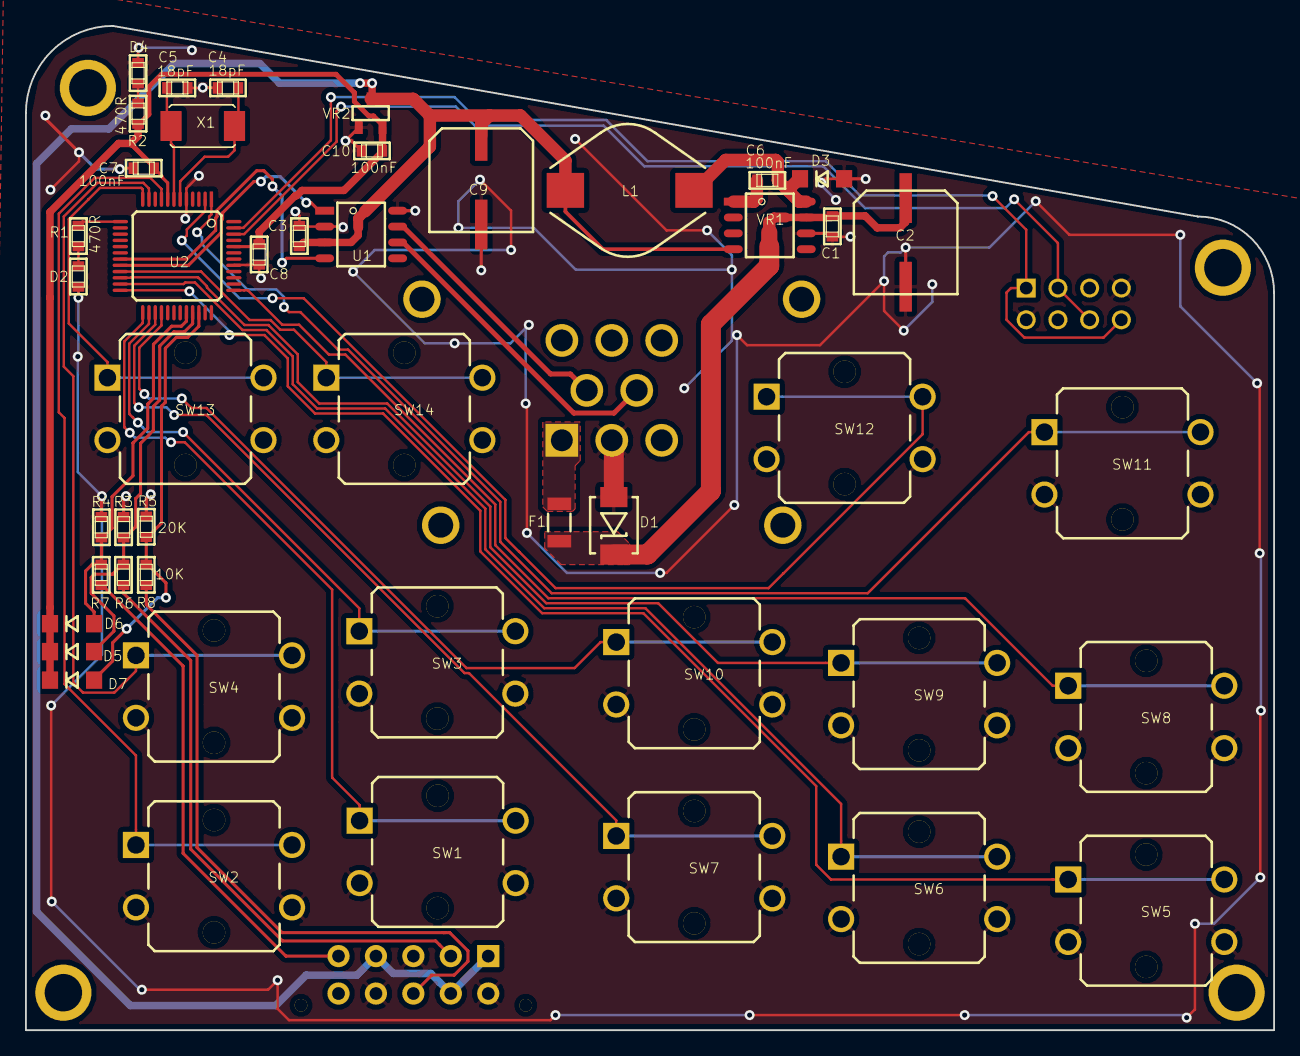
[picture p32: board right_keypad.kicad_pcb from above]

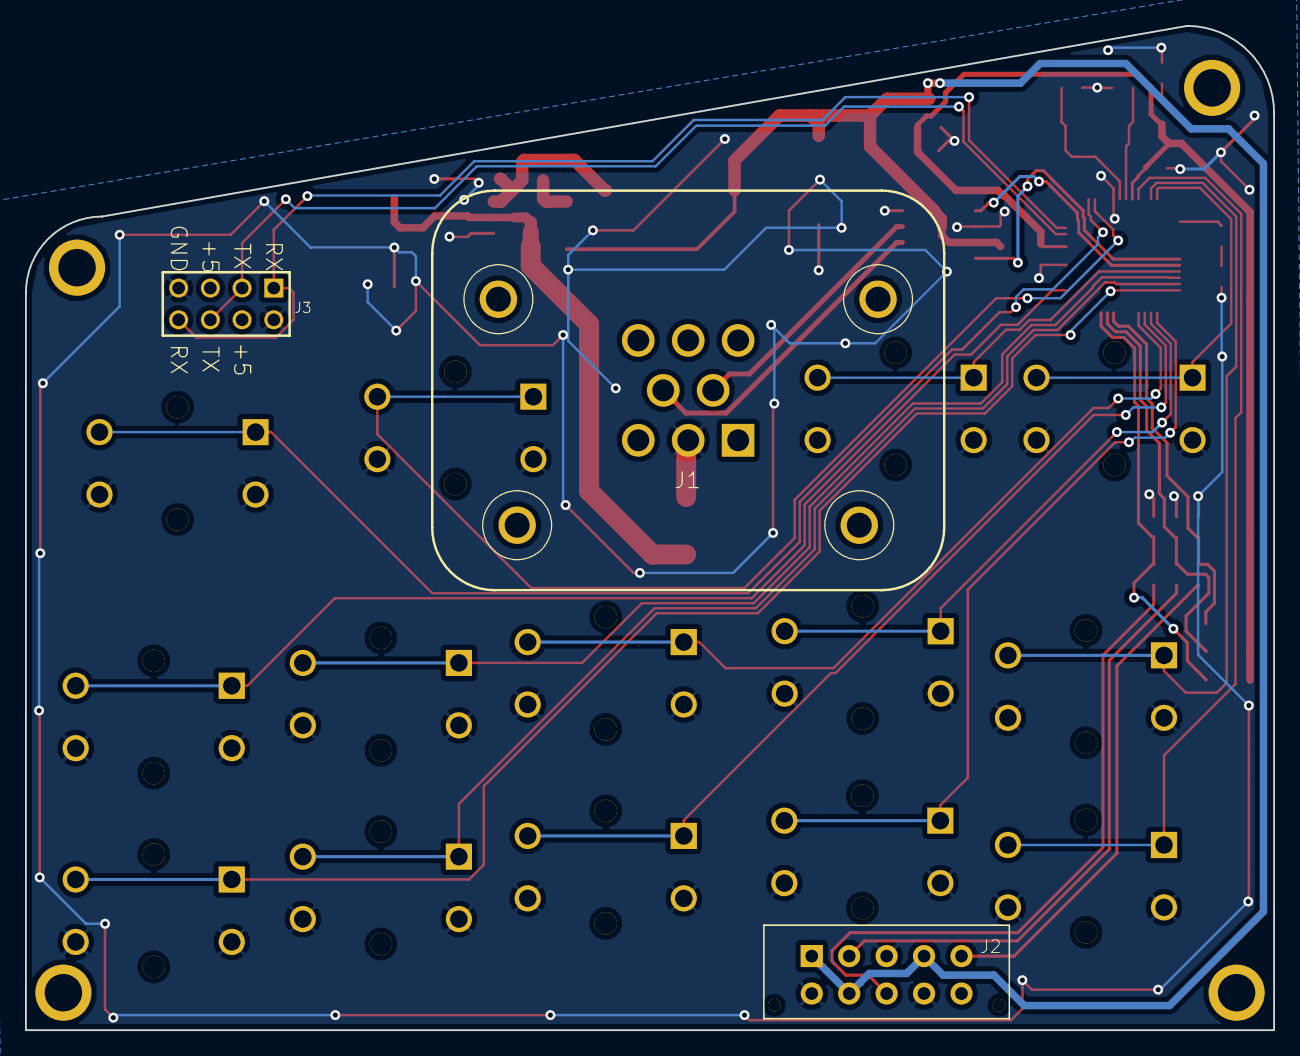
[picture p33: board right_keypad.kicad_pcb from below]

Board: 2 copper layers, 99.9 x 80.4 mm, 49 parts (3 on the bottom side), 38 nets.
