usevolt/keypad/hw/left_revision3_0.brd

## EAGLE design hw/left_revision3_0.brd (2016-03-28)

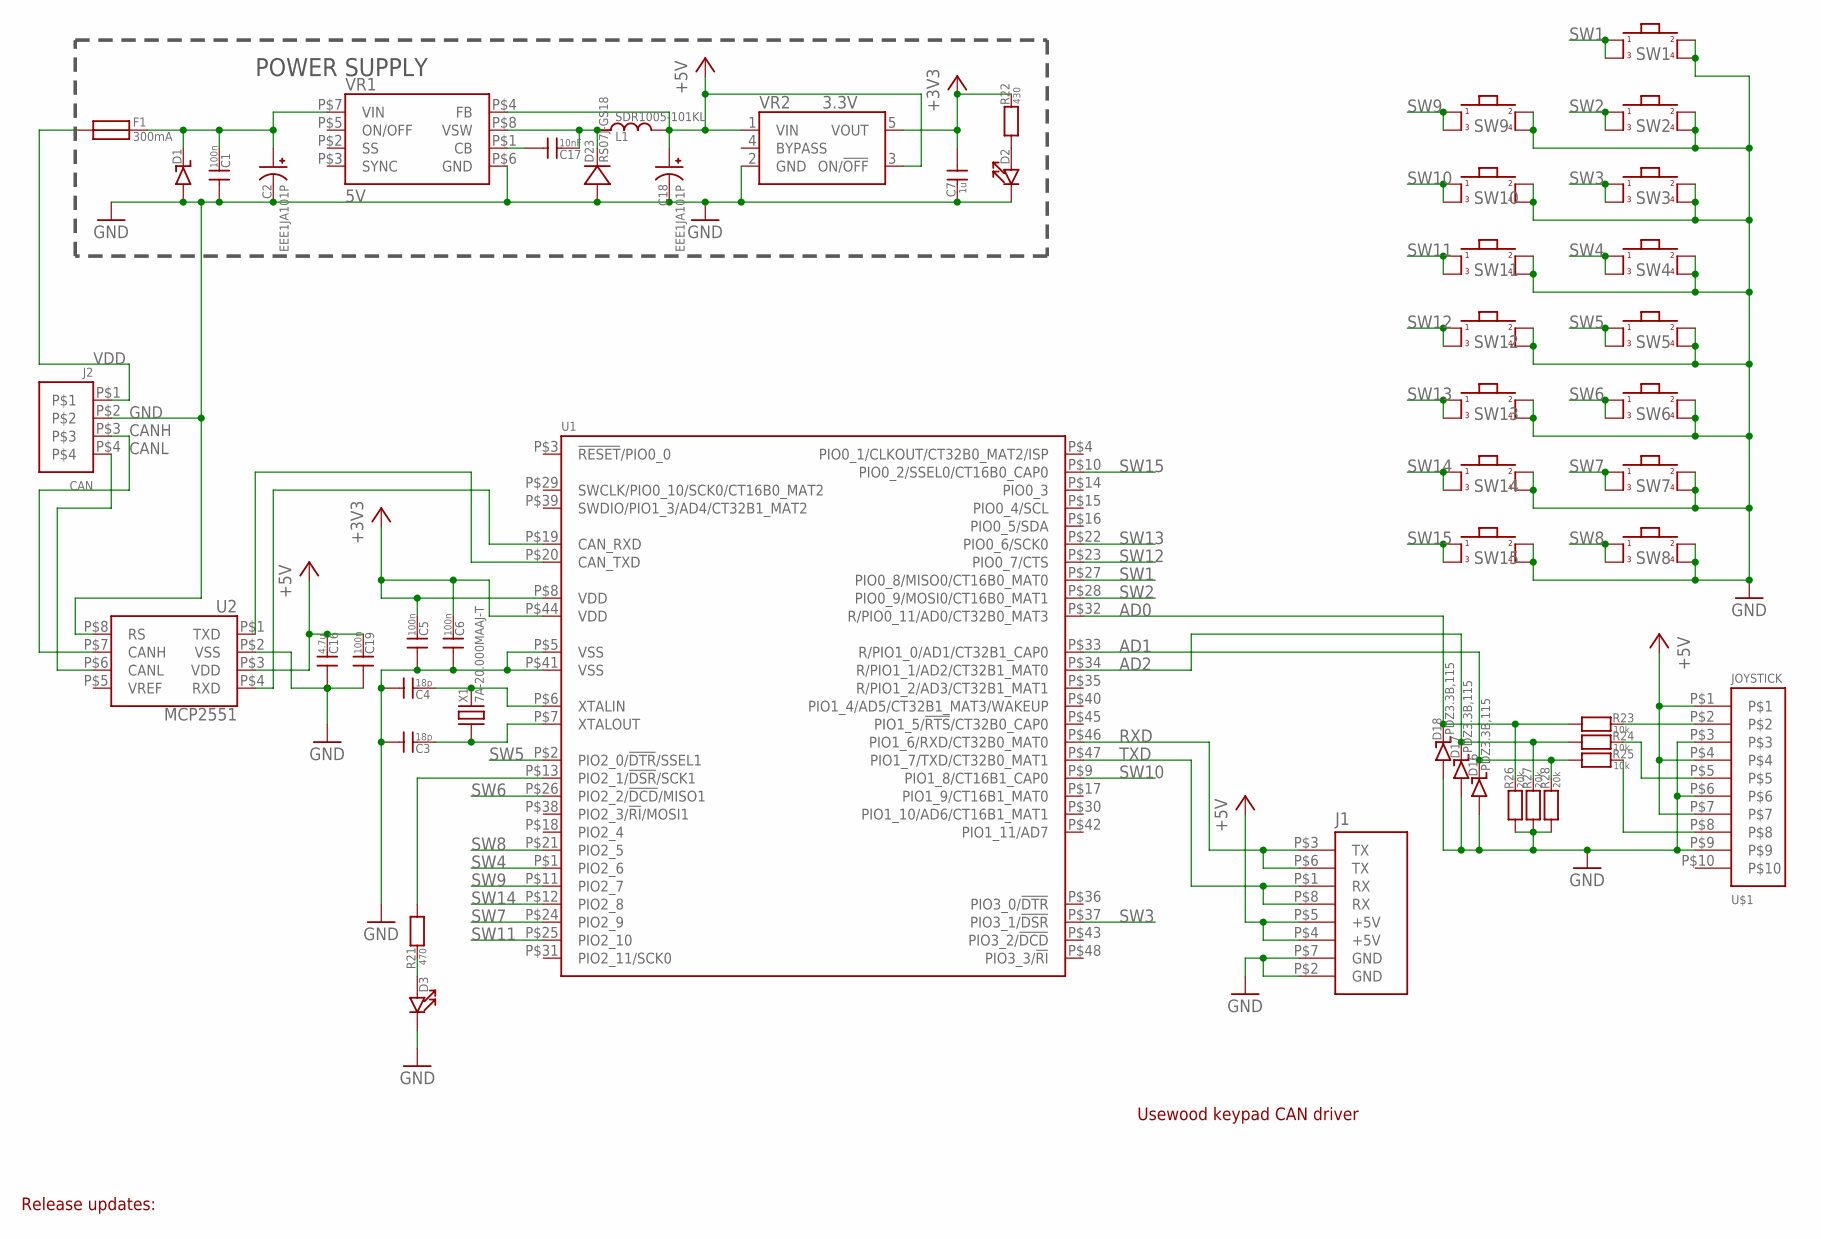
[picture p34: schematic left_revision3_0.sch]

Parts:
C1, C5, C6, C19: 100n; 0603_SILKSCREEN
C2, C18: EEE1JA101P; CAP_POL_SMD_10X10X10MM
C3, C4: 18p; 0603_SILKSCREEN
C7: 1u; 0603_SILKSCREEN
C16: 4.7u; 0603_SILKSCREEN
C17: 10nF; 0603_SILKSCREEN
D1: DIODE_TVSDO-214AA; DO-214AB
D2, D3: LED_0603; 0603_SILKSCREEN
D16, D17, D18: PDZ3.3B,115; SOD123
D23: RS07J-GS18; DO219AB
F1: 300mA; FUSE_100MA
J1: HEADER_USART_2_SMD; HEADER_4_2_SMD
J2: CAN; MOLEX_MICRO_FIT_4WAY_SMD
L1: SDR1005-101KL; INDUCTOR_BOURNS_10X13X5MM
R21: 470; 0603_SILKSCREEN
R22: 430; 0603_SILKSCREEN
R23, R24, R25: 10k; 0603_SILKSCREEN
R26, R27, R28: 20k; 0603_SILKSCREEN
SW1, SW2, SW3, SW4, SW5, SW6, SW7, SW8, SW9, SW10, SW11, SW12, SW13, SW14, SW15: SWITCH_EVQP6L; SWITCH_EVQ9P6B40
U1: LPC11C14_QFP48; QFP48
U2: MCP2551; SOIC8
U$1: JOYSTICK; MOLEX_MICRO_FIT_10WAY_SMD
VR1: 5V; SOIC8
VR2: 3.3V; SOP5
X1: 7A-20.000MAAJ-T; XTAL_SMD_5X3.2

Connections:
+3V3: C5.1, C6.1, C7.0, R22.1, U1.P$8 (VDD), U1.P$44 (VDD), VR2.5 (VOUT)
+5V: C16.1, C18.+, C19.1, J1.P$4 (+5V), J1.P$5 (+5V), L1.P$2, U2.P$3 (VDD), U$1.P$1, U$1.P$4, U$1.P$7, VR1.P$4 (FB), VR2.1 (VIN), VR2.3 (ON/!OFF)
AD0: D18.P$2 (N), R23.0, R26.1, U1.P$32 (R/PIO0_11/AD0/CT32B0_MAT3)
AD1: D16.P$2 (N), R25.0, R28.1, U1.P$33 (R/PIO1_0/AD1/CT32B1_CAP0)
AD2: D17.P$2 (N), R24.0, R27.1, U1.P$34 (R/PIO1_1/AD2/CT32B1_MAT0)
CANH: J2.P$3, U2.P$7 (CANH)
CANL: J2.P$4, U2.P$6 (CANL)
GND: C1.0, C2.-, C3.0, C4.0, C5.0, C6.0, C7.1, C16.0, C18.-, C19.0, D1.P$1, D2.1, D3.1, D16.P$1, D17.P$1, D18.P$1, D23.P$1, J1.P$2 (GND), J1.P$7 (GND), J2.P$2, R26.0, R27.0, R28.0, SW1.B, SW1.B', SW2.B, SW2.B', SW3.B, SW3.B', SW4.B, SW4.B', SW5.B, SW5.B', SW6.B, SW6.B', SW7.B, SW7.B', SW8.B, SW8.B', SW9.B, SW9.B', SW10.B, SW10.B', SW11.B, SW11.B', SW12.B, SW12.B', SW13.B, SW13.B', SW14.B, SW14.B', SW15.B, SW15.B', U1.P$5 (VSS), U1.P$41 (VSS), U2.P$2 (VSS), U2.P$8 (RS), U$1.P$3, U$1.P$6, U$1.P$9, VR1.P$6 (GND), VR2.2 (GND)
LED3: D3.0, R21.1
unnamed: R21.0, U1.P$13 (PIO2_1/!DSR!/SCK1)
unnamed: D2.0, R22.0
unnamed: C1.1, C2.+, D1.P$2 (N), F1.P$2, VR1.P$7 (VIN)
unnamed: U1.P$20 (CAN_TXD), U2.P$1 (TXD)
unnamed: C17.1, D23.P$2 (N), L1.P$1, VR1.P$8 (VSW)
unnamed: U1.P$19 (CAN_RXD), U2.P$4 (RXD)
unnamed: C17.0, VR1.P$1 (CB)
RXD: J1.P$3 (TX), J1.P$6 (TX), U1.P$46 (PIO1_6/RXD/CT32B0_MAT0)
SW1: SW1.A, SW1.A', U1.P$27 (PIO0_8/MISO0/CT16B0_MAT0)
SW2: SW2.A, SW2.A', U1.P$28 (PIO0_9/MOSI0/CT16B0_MAT1)
SW3: SW3.A, SW3.A', U1.P$37 (PIO3_1/!DSR)
SW4: SW4.A, SW4.A', U1.P$1 (PIO2_6)
SW5: SW5.A, SW5.A', U1.P$2 (PIO2_0/!DTR!/SSEL1)
SW6: SW6.A, SW6.A', U1.P$26 (PIO2_2/!DCD!/MISO1)
SW7: SW7.A, SW7.A', U1.P$24 (PIO2_9)
SW8: SW8.A, SW8.A', U1.P$21 (PIO2_5)
SW9: SW9.A, SW9.A', U1.P$11 (PIO2_7)
SW10: SW10.A, SW10.A', U1.P$9 (PIO1_8/CT16B1_CAP0)
SW11: SW11.A, SW11.A', U1.P$25 (PIO2_10)
SW12: SW12.A, SW12.A', U1.P$23 (PIO0_7/CTS)
SW13: SW13.A, SW13.A', U1.P$22 (PIO0_6/SCK0)
SW14: SW14.A, SW14.A', U1.P$12 (PIO2_8)
SW15: SW15.A, SW15.A', U1.P$10 (PIO0_2/SSEL0/CT16B0_CAP0)
TXD: J1.P$1 (RX), J1.P$8 (RX), U1.P$47 (PIO1_7/TXD/CT32B0_MAT1)
VDD: F1.P$1, J2.P$1
XJOY: R23.1, U$1.P$2
XTALIN: C4.1, U1.P$6 (XTALIN), X1.P$2
XTALOUT: C3.1, U1.P$7 (XTALOUT), X1.P$1
YJOY: R24.1, U$1.P$5
ZJOY: R25.1, U$1.P$8

Notes on the sheet:
Usewood keypad CAN driver
POWER SUPPLY
Release updates:

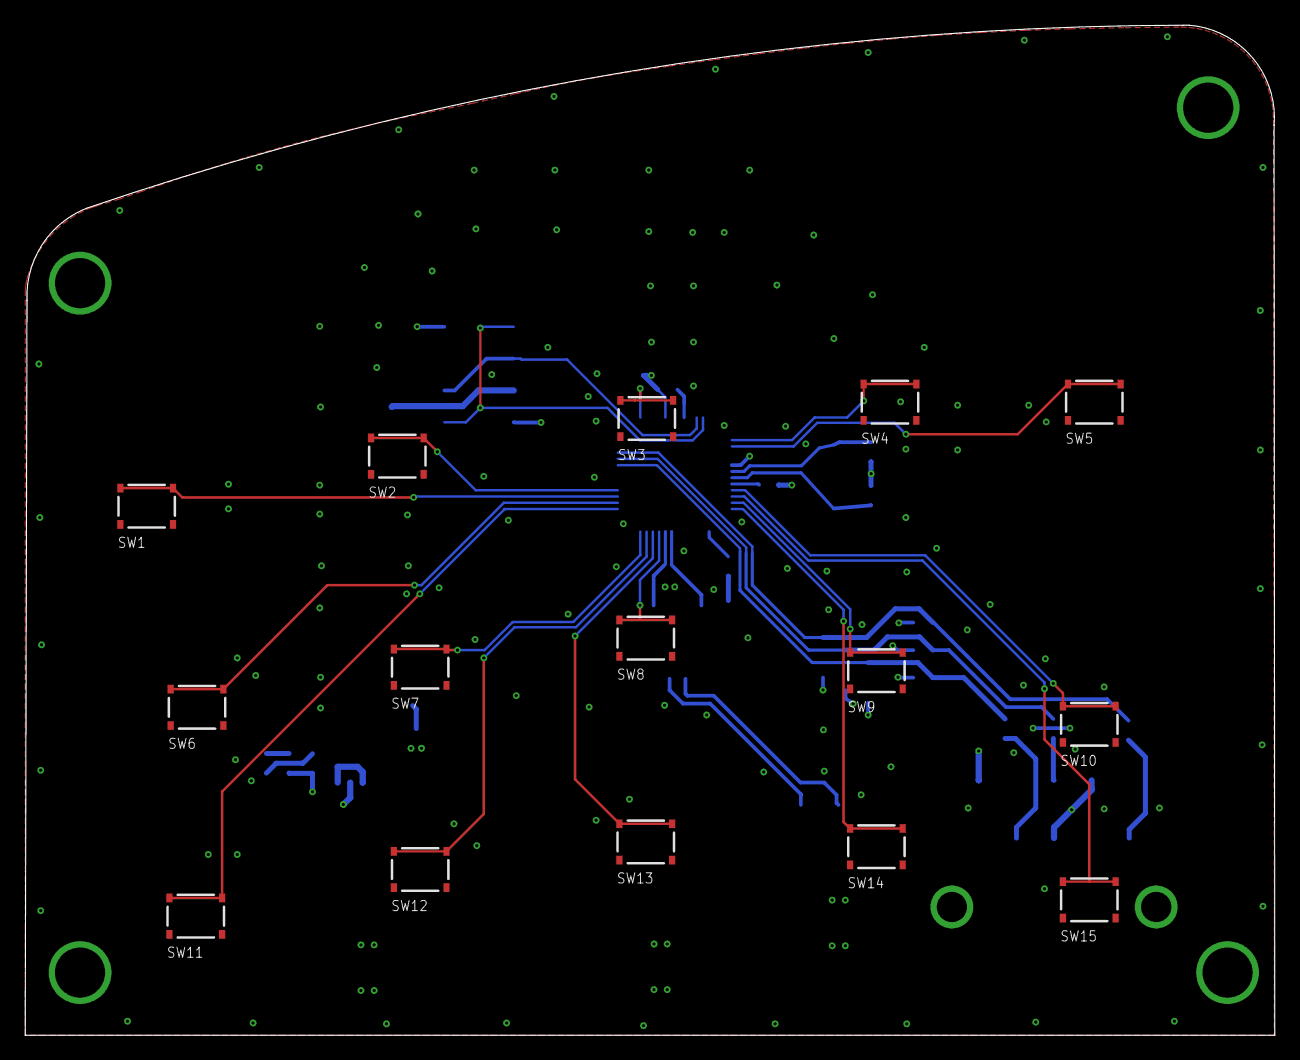
[picture p35: board left_revision3_0.brd from above]

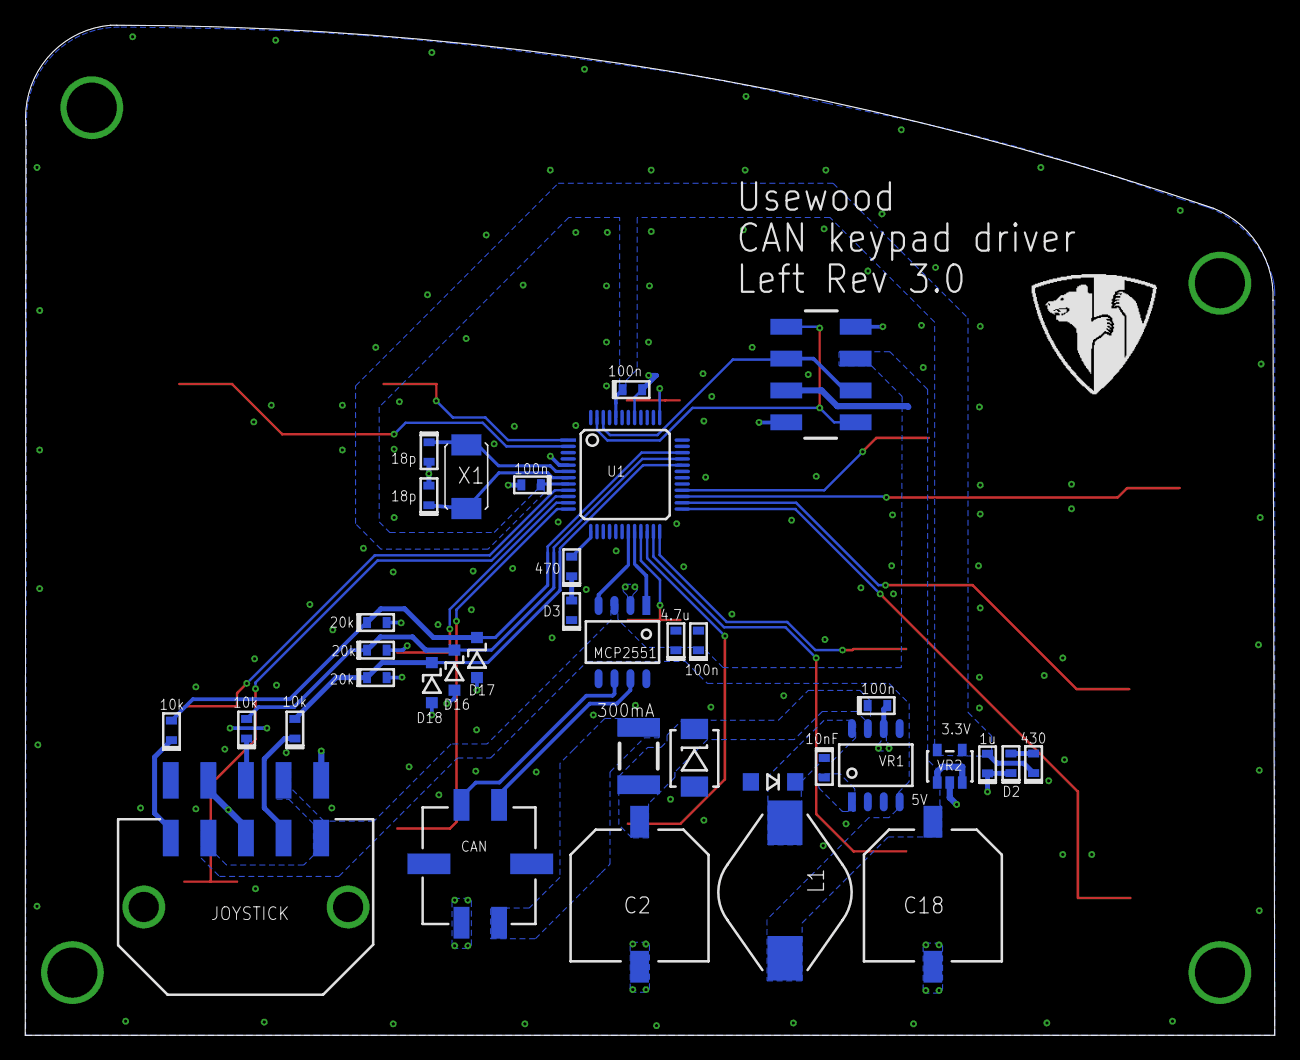
[picture p36: board left_revision3_0.brd from below]

Board: 2 copper layers, 99.7 x 80.6 mm, 51 parts (36 on the bottom side), 39 nets.
