usevolt/keypad/sw/inc/buttons.h

/*
 * uw_buttons.h
 *
 *  Created on: Jan 29, 2015
 *      Author: usenius
 */

#ifndef BUTTONS_H_
#define BUTTONS_H_

#include <stdbool.h>
#include <stdint.h>
#include <uv_gpio.h>


typedef struct {
	int8_t is_down;
	int8_t pressed;
	int8_t released;
	int8_t clicked;
} uv_button_st;

#define BUTTON_ARRAY_SIZE	4


#define BUTTON_INIT(button_ptr) \
		((uv_button_st*) button_ptr)->is_down = false; \
		((uv_button_st*) button_ptr)->pressed = false; \
		((uv_button_st*) button_ptr)->released = false


void button_step(uv_button_st *this, bool gpio_value, bool gpio_value_neg);


static inline bool button_is_down(uv_button_st* b) {
	return b->is_down;
}

static inline bool button_pressed(uv_button_st *b) {
	return b->pressed;
}

static inline bool button_released(uv_button_st *b) {
	return b->released;
}



#endif /* BUTTONS_H_ */
