usevolt/keypad/(commit log)

2016-02-23 Add initial SW and HW files
    - copy sw & hw versions 0.5, 1.0 & 1.1 from svn version control
    - change hal library paths to point into LPC11C14 in version_control/hal
    [keypad_obj_dict.xlsx, left_revision0_5.brd, left_revision0_5.sch, left_revision0_6.brd, left_revision0_6.sch, lpc11xx.pll_.calculator.xlsx, proto.brd, proto.sch]
2016-03-03 Add 1.0, 1.1 & 1.2 HW versions to version control
    - They were missing from last commit
    [left_revision1_0.brd, left_revision1_0.sch, left_revision1_1.brd, left_revision1_1.sch, left_revision1_2.brd, left_revision1_2.sch, right_revision1_0.brd, right_revision1_0.sch]
2016-03-28 Add 2.0 and 3.0 HW versions
    [l_keypad_buttons_2_0.blend, l_keypad_buttons_2_0.stl, l_keypad_buttons_3_0.blend, l_keypad_buttons_3_0.stl, left_revision1_2.brd, left_revision2_0.brd, left_revision2_0.sch, left_revision3_0.brd]
2016-04-30 version 3.0 hardware drawn
    [left_revision3_1.brd, left_revision3_1.sch, right_revision3_1.brd, right_revision3_1.sch]
2016-05-18 Deleted old HW revision files
    [left.brd, left.sch, left_revision0_5.brd, left_revision0_5.sch, left_revision0_6.brd, left_revision0_6.sch, left_revision1_0.brd, left_revision1_0.sch]
2016-06-16 HW revision 3.0
    [right.sch]
2016-06-19 developing HW version 4.0
    [left.brd, left.sch, right.brd, right.sch]
2016-09-08 Designing the kicad version of hw
    [keypad.FCStd, keypad.kicad_pcb, keypad.sch, left.brd, right.brd, right.sch]
2016-10-24 revision 5 ordered from itead
    [keypad.FCStd, keypad.kicad_pcb, keypad.sch, l_keypad_buttons_2_0.stl, l_keypad_buttons_3_0.stl, left.sch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]
2016-12-22 implementing firmware for 5.0 hw
    [button_base.step, left_keypad.FCStd, right_keypad.sch, right_keypad.stl, switch_base.step]
2017-01-25 Created covers and ordered them from shapeways
    [button_hole_base.step, left_buttons.stl, left_cover.stl, left_keypad.FCStd, right_buttons.stl, right_cover.stl, switch_hole_base.step]
2017-02-08 ordupdated enclosures to have 4 round buttons instead of 2 switches
    [button_bases.fcstd, left_buttons.stl, left_cover.stl, right_buttons.stl, right_cover.stl]
2017-03-10 not working version with renewed object dictionary interface
    [axis.c, axis.h, buttons.c, buttons.h, main.c, main.h, messages.c]
2017-03-11 pcb hw revision 5 software with new obj dict interface
2017-03-28 hw but 5 & 6 rotated 20 degrees to fit their places
    [UWP-01004.STEP, UWP-01008.STEP, button_base.step, button_bases.fcstd, button_hole_base.step, l_keypad_buttons_2_0.blend, l_keypad_buttons_3_0.blend, left_buttons.stl]
2017-03-31 axis calibration available only if axis has no active error
    [axis.c]
2017-04-01 screw hole pocket radius increased
    [left_cover.stl, right_cover.stl]
2017-04-04 axis calibration min & max value added threshold
    Hopefully reduced hazards, since min cannot be greater or equal to middle value, same for max.
2017-04-11 bug fix: Axis calib msb obj's array length corrected
    [messages.c]
2017-05-18 enclosure bug fixes:
    2 outermost button's rotation corrected
    cover's border thickness increased for good 3d print manufacturing
    [left_buttons.stl, left_cover.stl, right_buttons.stl, right_cover.stl]
2017-06-27 enclosure plane thickness is now constant 1.0 mm
    [left_buttons.stl, right_buttons.stl]
2017-07-10 added OTTO JHM model and created assembly file
    [UWP-01004.STEP, UWP-01004.step, UWP-01008.STEP, left_collar.step, left_collar_bottom_mold.step, left_collar_top_mold.step]
2017-07-12 version 3 top collar ordered from shapeways
    [button_base.step, button_bases.fcstd, button_hole_base.step, collar_top.stl, sw_base.step, sw_hole_base.step]
2017-12-17 drawing right2 pcb
    [button_edges.dxf, button_edges_right.dxf, joystick_edges.dxf, joystick_edges_right.dxf, left2.FCStd, left2.kicad_pcb, left2.sch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]
2018-08-27 sw compiles without dependencies to lpcxpresso
    [collar_bottom.iges, collar_top.iges]
2018-08-27 button count reduced, b5, 6, 7 grouped together
2019-01-26 stencil gerbers created from old keypads
    [right_keypad-Edge.Cuts.gm1, right_keypad-F.Paste.gtp]
2019-06-02 button plastics updated to imaterialise ordering
    [left_buttons.stl, right_buttons.stl]
2021-10-26 covers without buttons step and stl created
    [left_cover_without_buttons.step, left_cover_without_buttons.stl, right_cover_without_buttons.step, right_cover_without_buttons.stl]
